NU-Horizonsat/ADCS-Camera-Payload-Board/RT1050.step

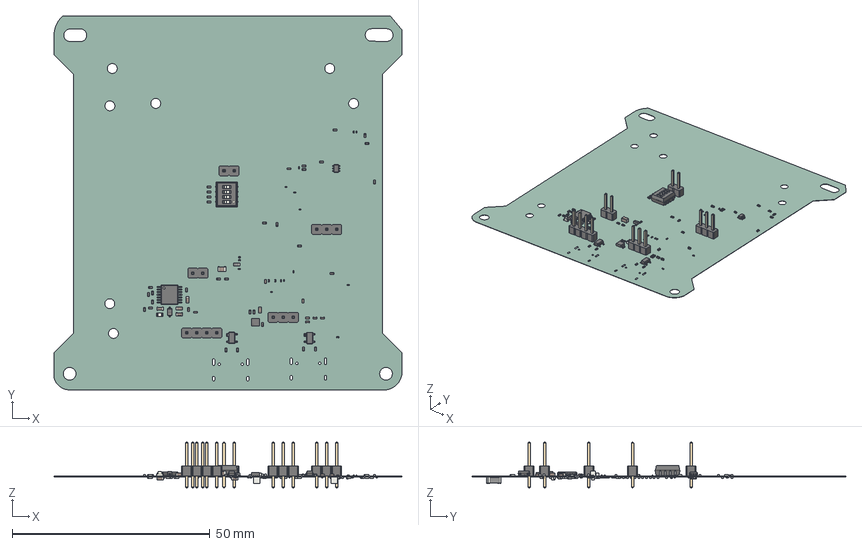
[picture p1: CAD file, 2025-04-02]
RT1050.step
88.0 x 94.5 x 11.5 mm
C_0201_0603Metric x 61
R_0402_1005Metric x 67
D_SOD-323
C_0603_1608Metric x 7
C_0402_1005Metric x 17
PinHeader_1x03_P2.54mm_Vertical x 2
SOT-143 x 2
SOT-363_SC-70-6
C_0805_2012Metric
LED_0603_1608Metric
TSSOP-14_4.4x5mm_P0.65mm
SW_DIP_SPSTx04_Slide_Copal_CHS-04A_W5.08mm_P1.27mm_JPin
PinHeader_1x02_P2.54mm_Vertical x 2
PinHeader_1x04_P2.54mm_Vertical
WSON-8-1EP_2x2mm_P0.5mm_EP0.9x1.6mm
L_0603_1608Metric
L_0402_1005Metric x 2
L_1206_3216Metric x 2
RT1050_PCB
