NU-Horizonsat/ADCS-Camera-Payload-Board/RT1050.pdf

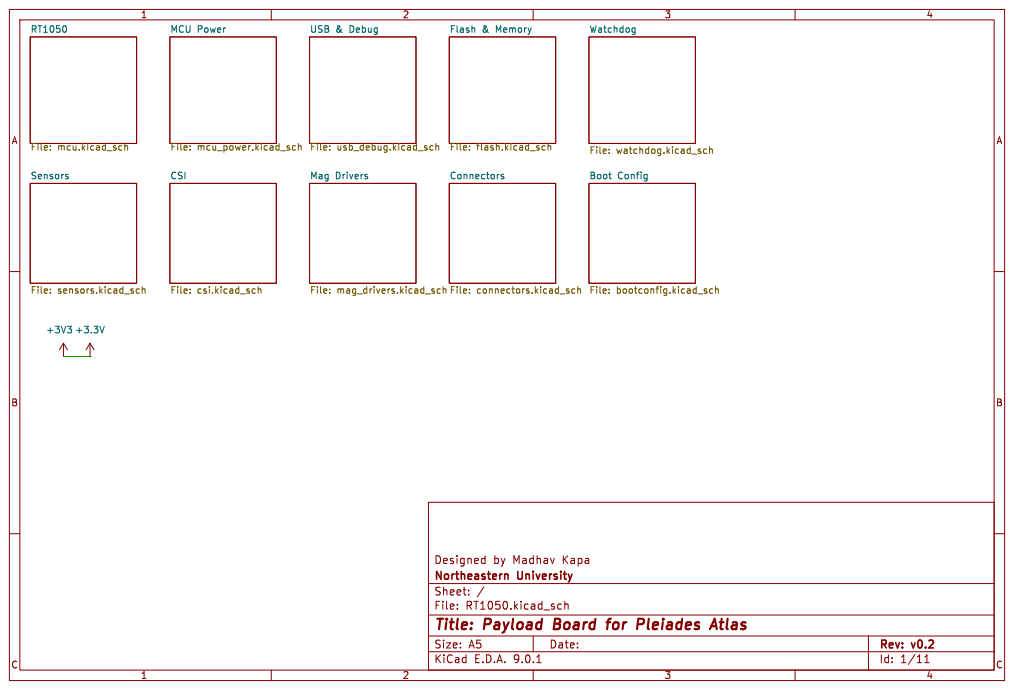
[picture p2: page 1]

Id: 1/11 Title: Payload Board for Pleiades Atlas

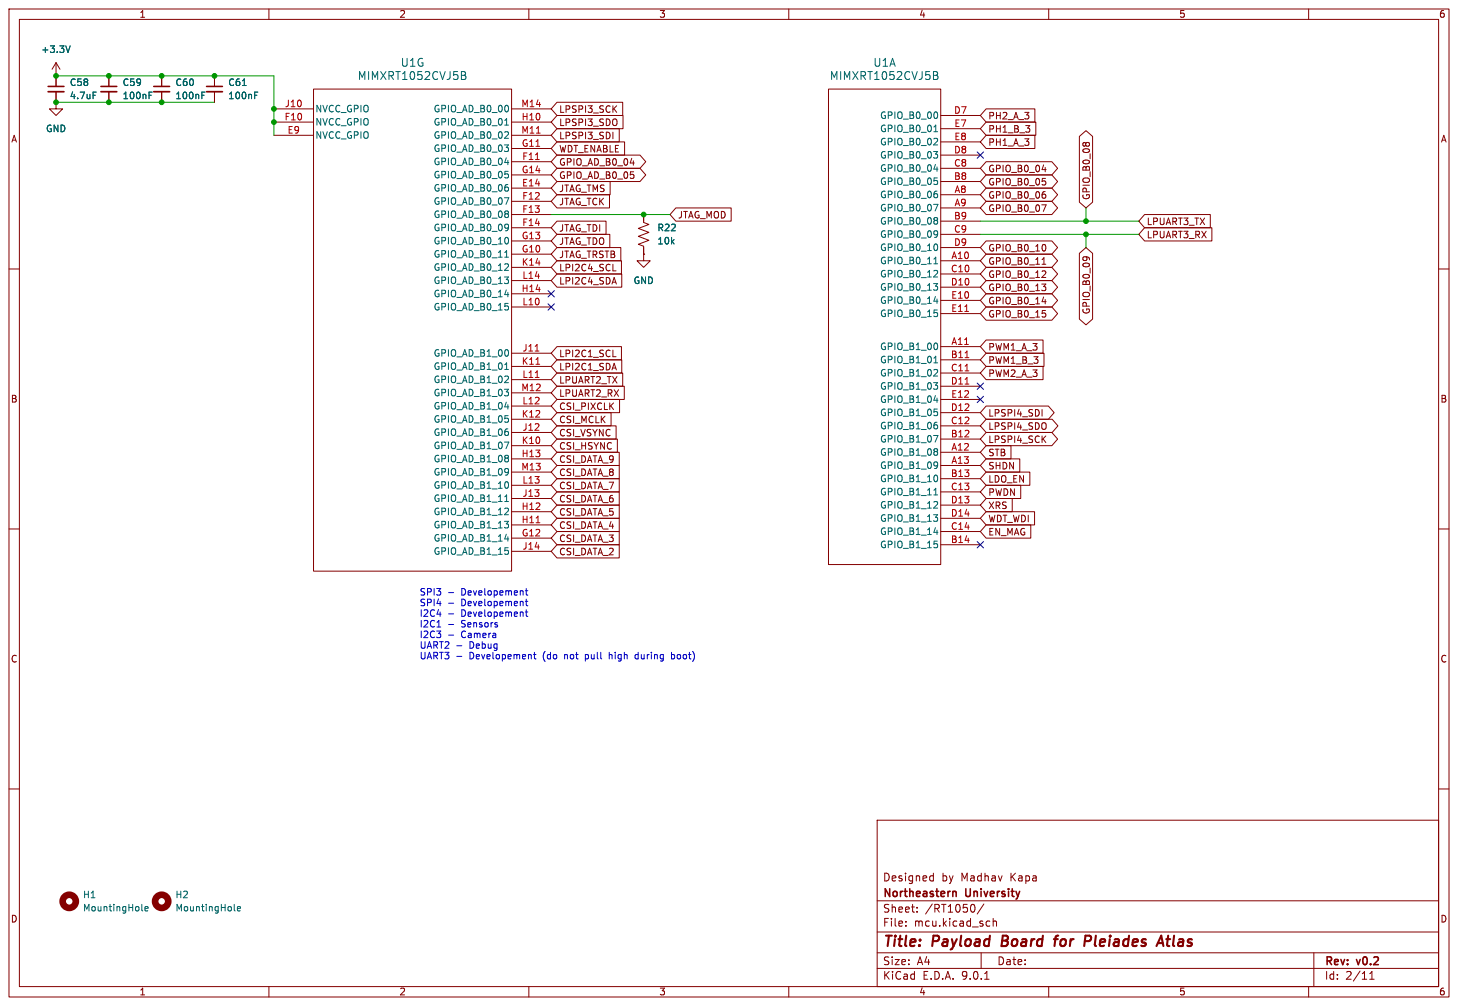
[picture p3: page 2]

Id: 2/11 Title: Payload Board for Pleiades Atlas

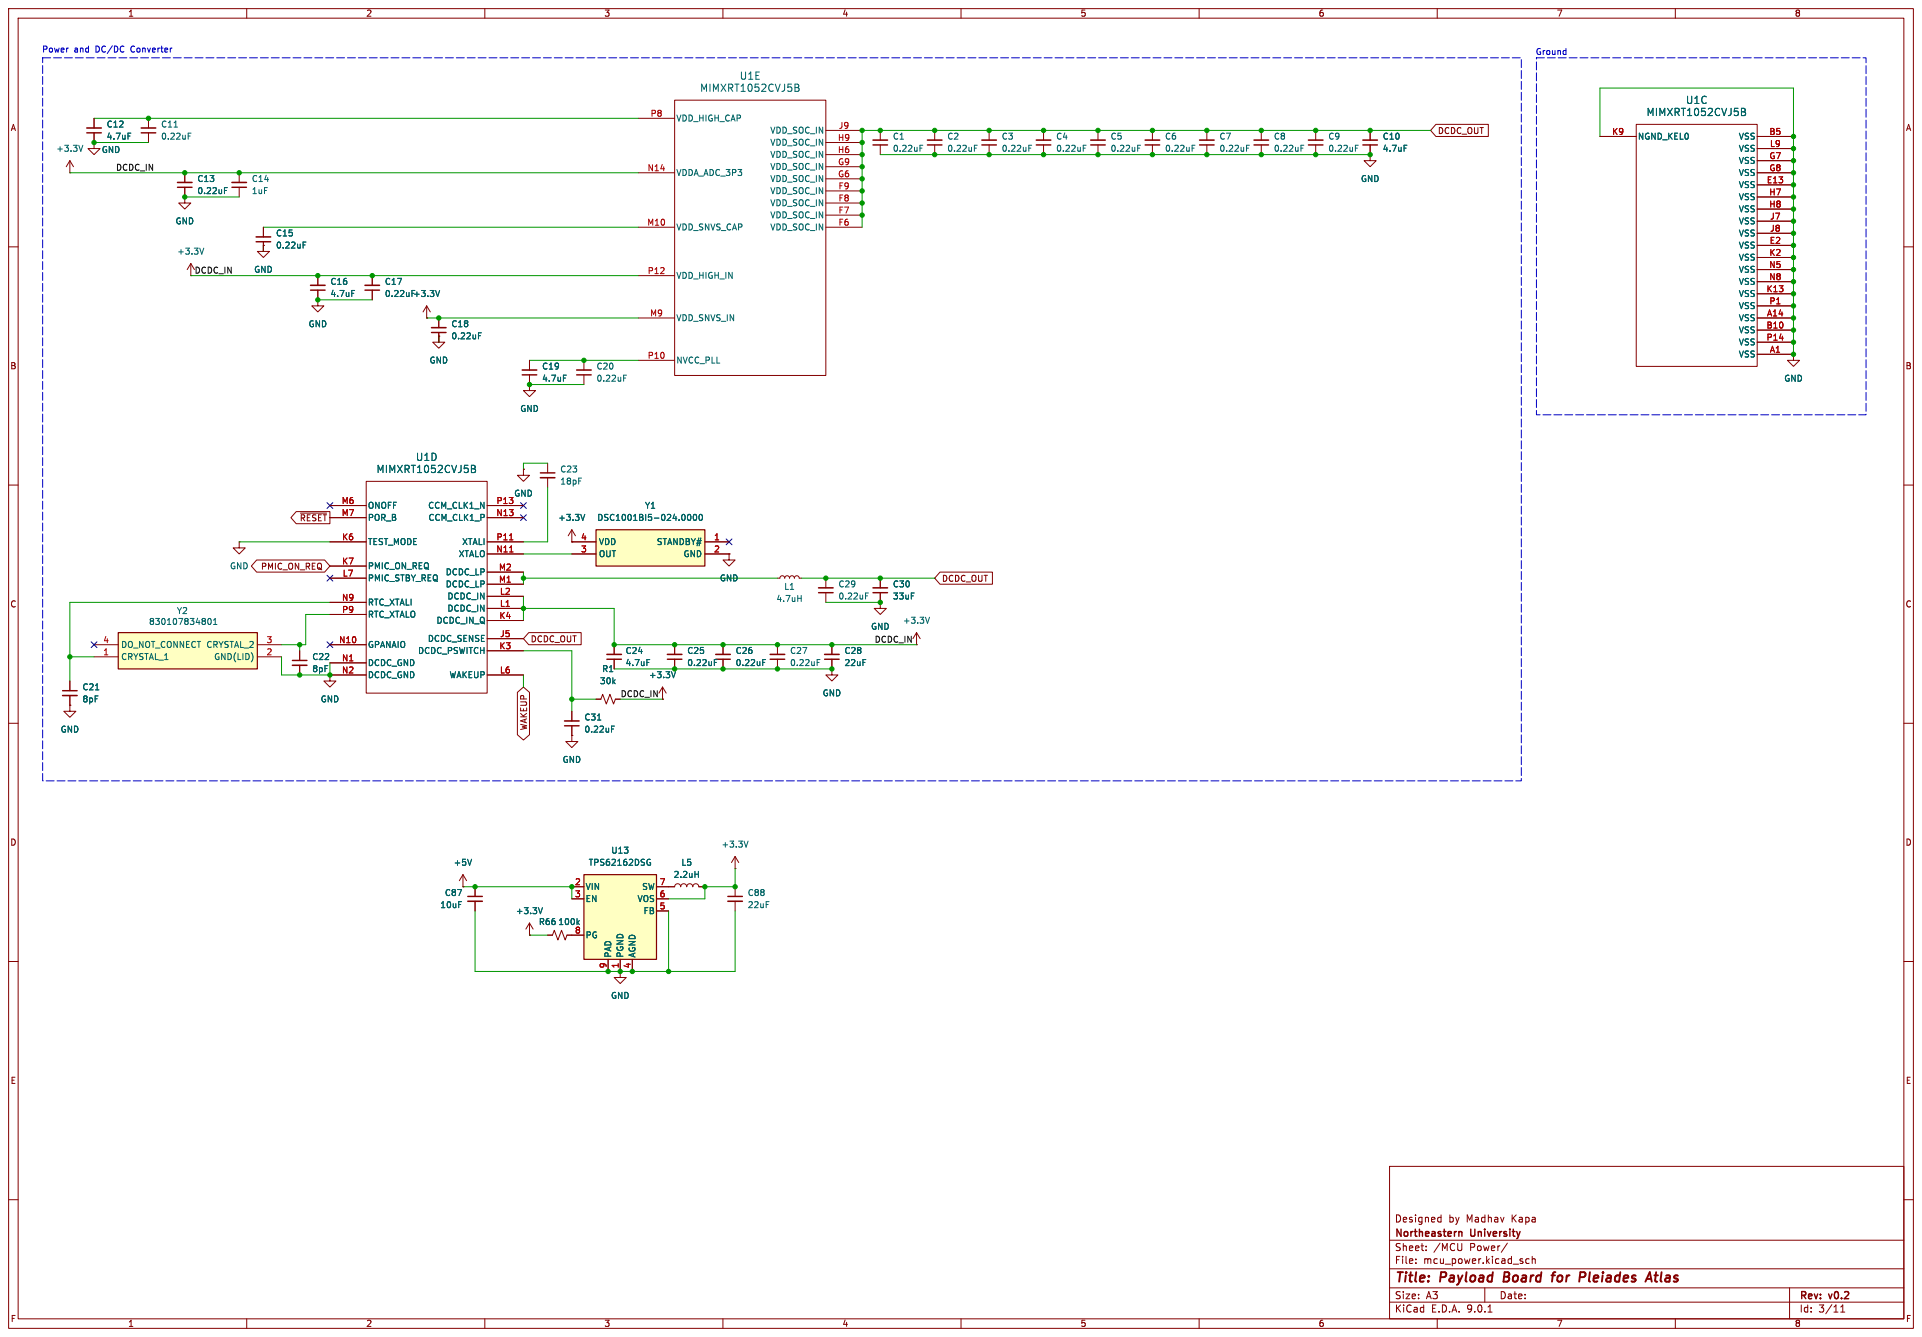
[picture p4: page 3]

Id: 3/11 Title: Payload Board for Pleiades Atlas

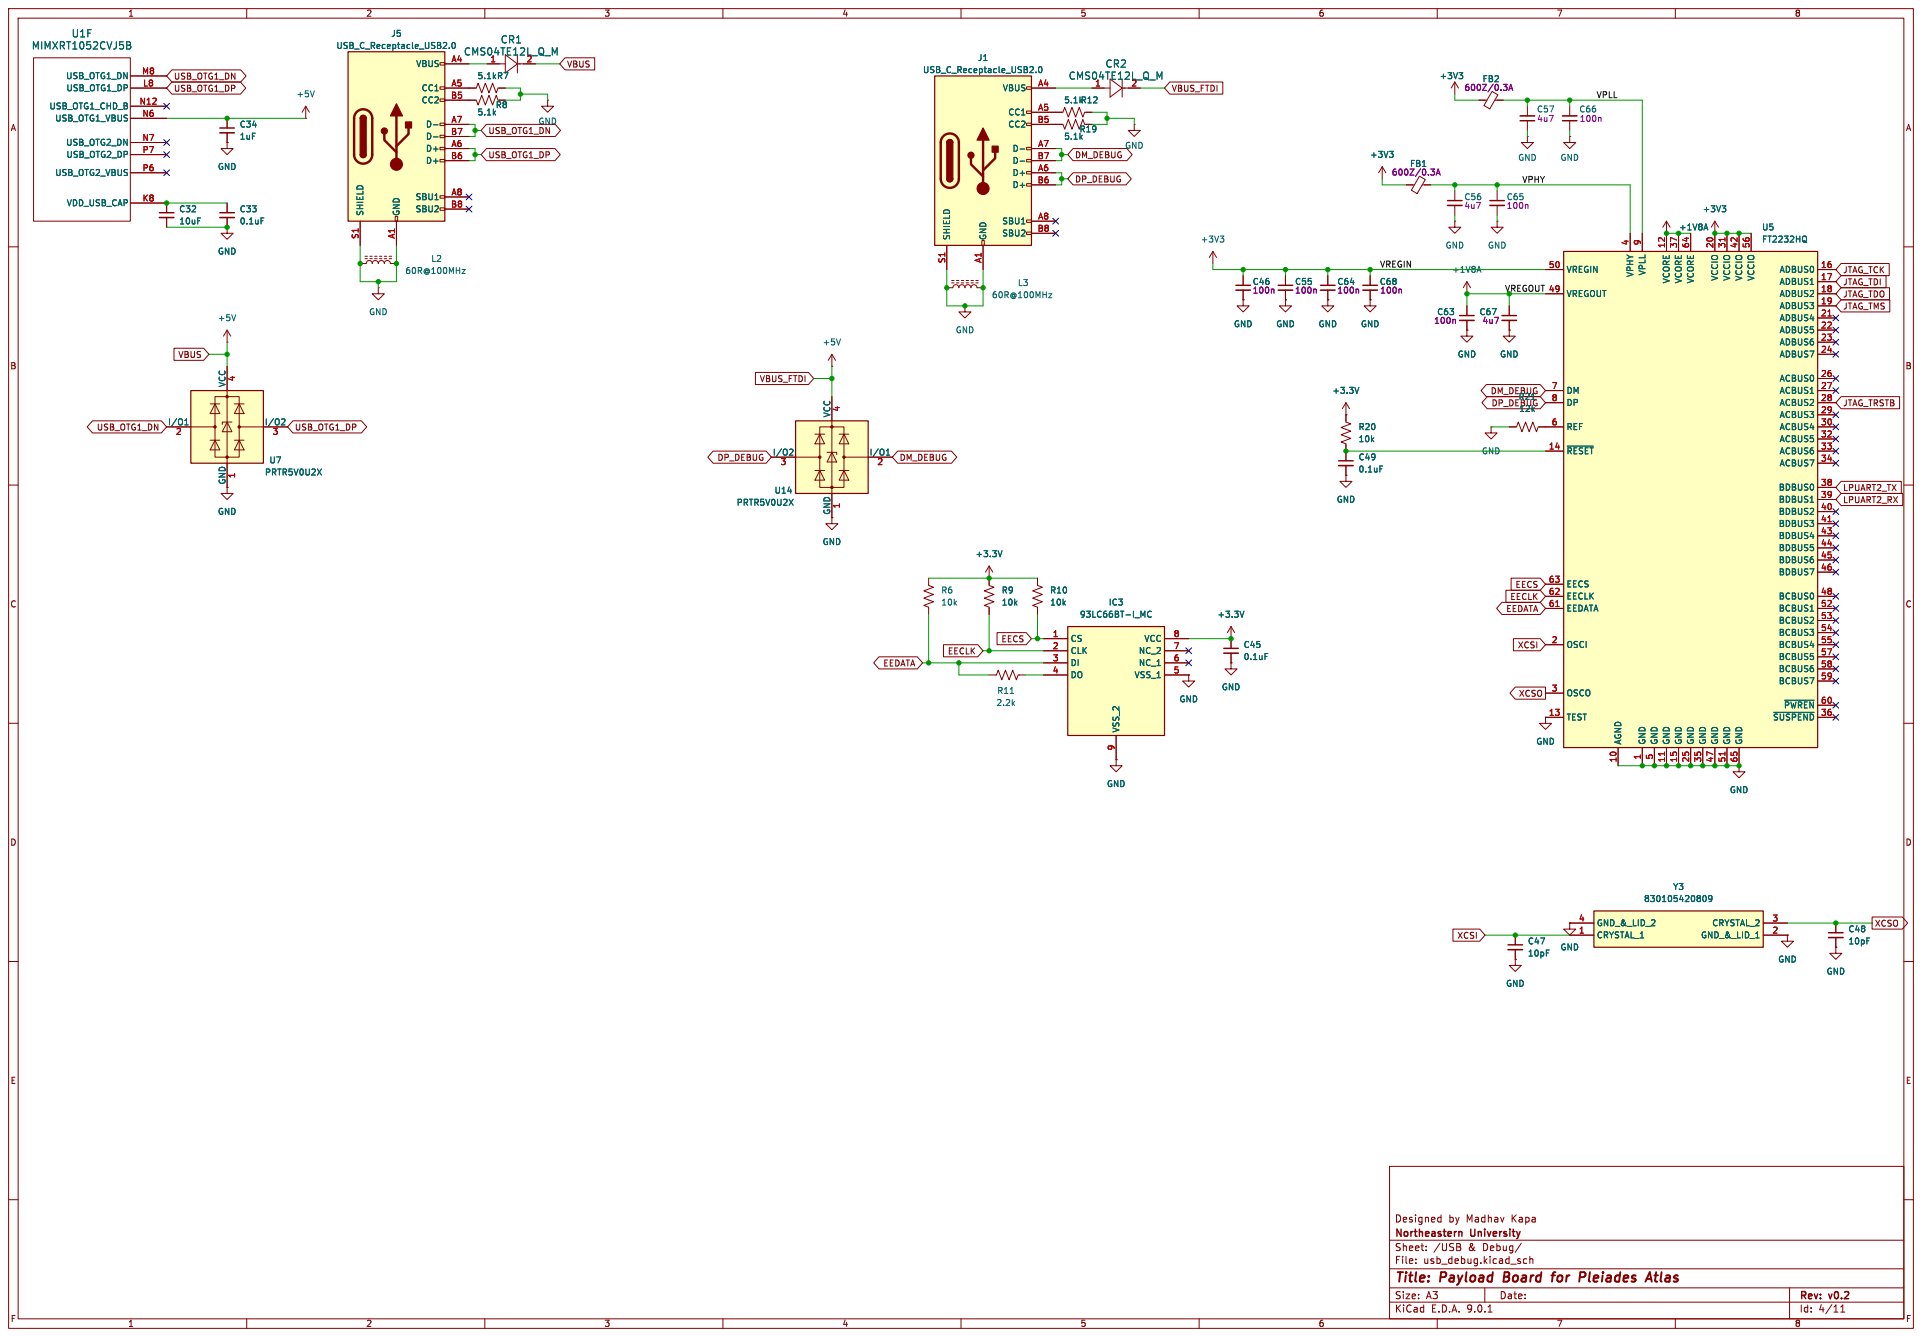
[picture p5: page 4]

5 VCORE 12 GND 11 VCORE 37 GND 15 VCORE 64 GND 25 GND 35 VCCIO 20 GND 47 VCCIO 31 GND 51 VCCIO 42 GND 65 VCCIO 56 ADBUS0

Id: 4/11 Title: Payload Board for Pleiades Atlas

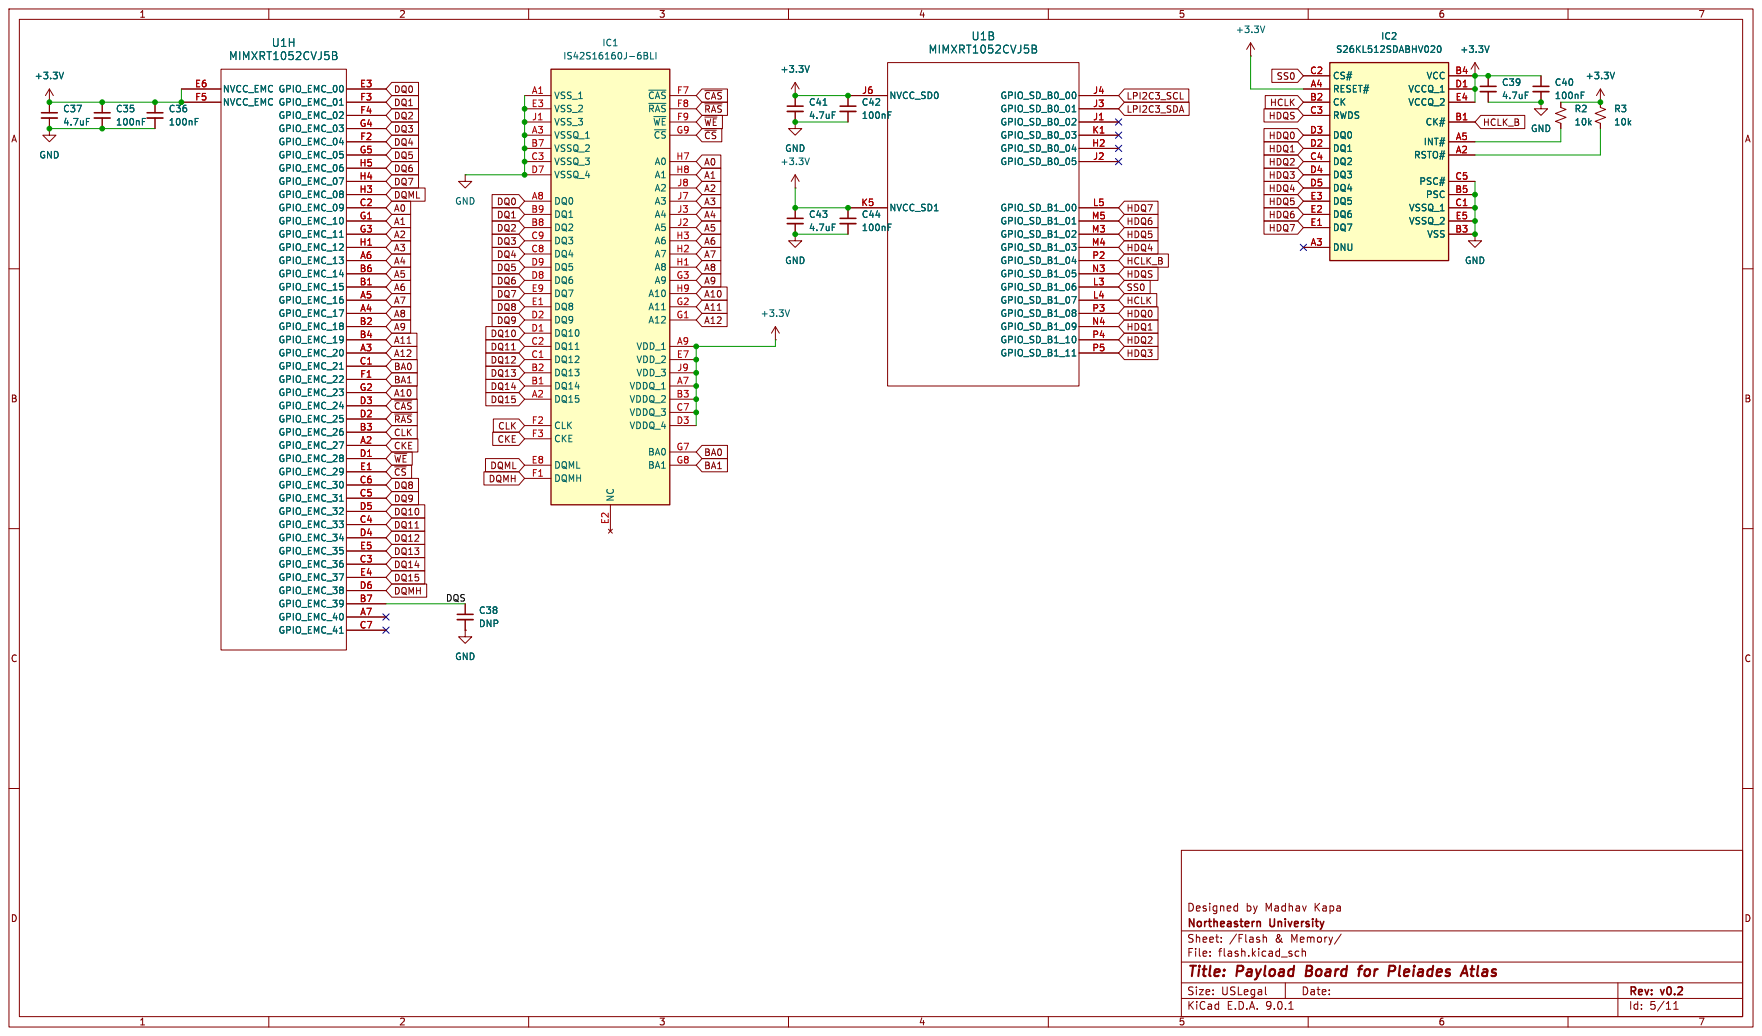
[picture p6: page 5]

~{CAS}F7 ~{RAS}F8 ~{WE}F9 ~{CS}G9 A0 H7 A1 H8 A2 J8 A3 J7 A4 J3 A5 J2 A6 H3 A7 H2 A8 H1 A9 G3 A10 H9 A11 G2 A12 G1 VDD_1 A9 VDD_2 E7 VDD_3 J9 VDDQ_1 A7 VDDQ_2 B3 VDDQ_3 C7 VDDQ_4 D3 BA0 G7 BA1 G8

Id: 5/11 Title: Payload Board for Pleiades Atlas

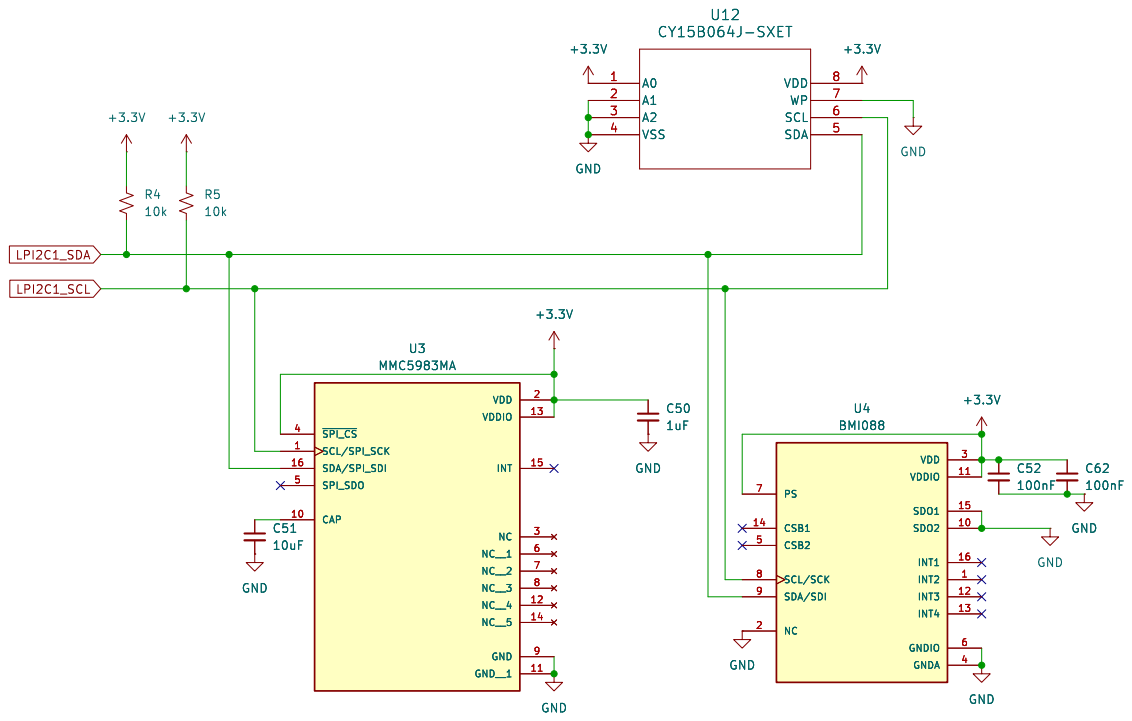
[picture p7: page 6]

Id: 6/11 Title: Payload Board for Pleiades Atlas

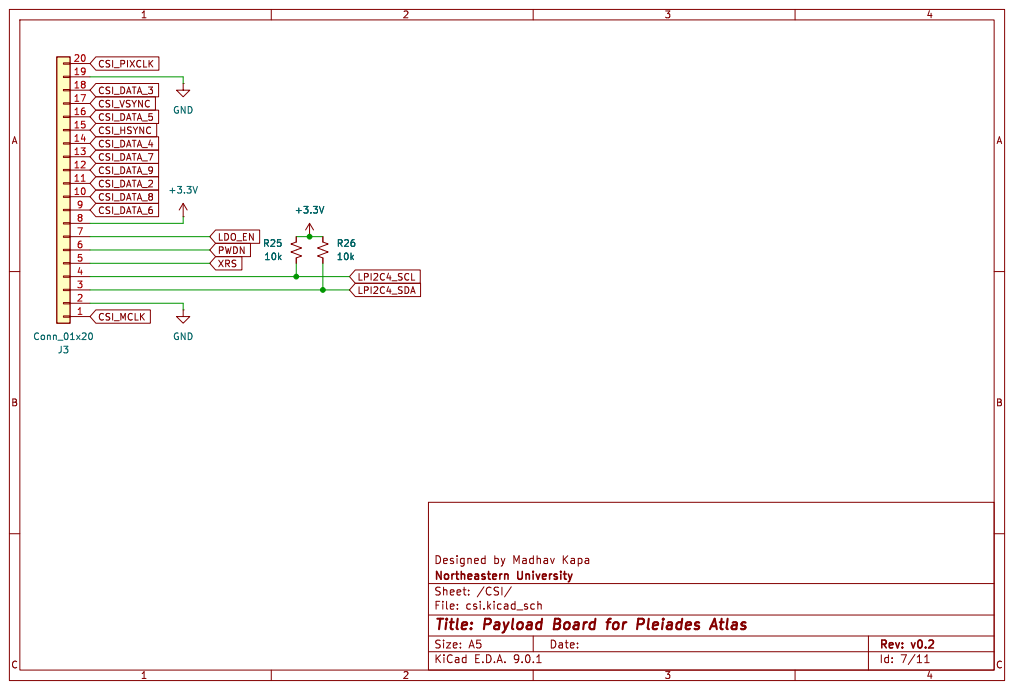
[picture p8: page 7]

Id: 7/11 Title: Payload Board for Pleiades Atlas

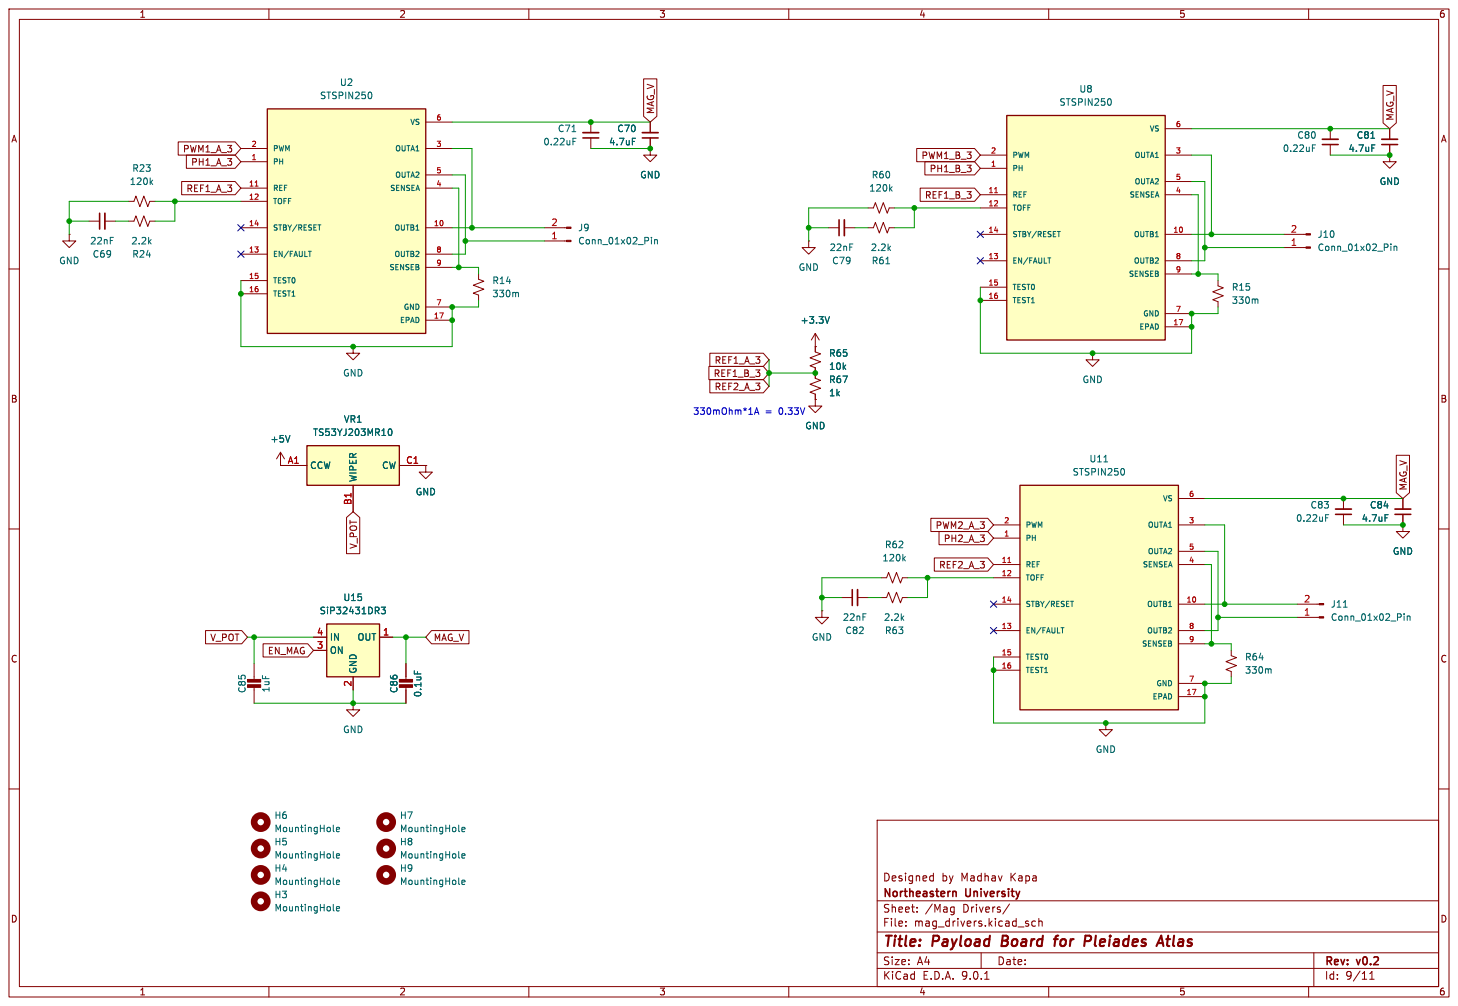
[picture p9: page 8]

Id: 9/11 Title: Payload Board for Pleiades Atlas

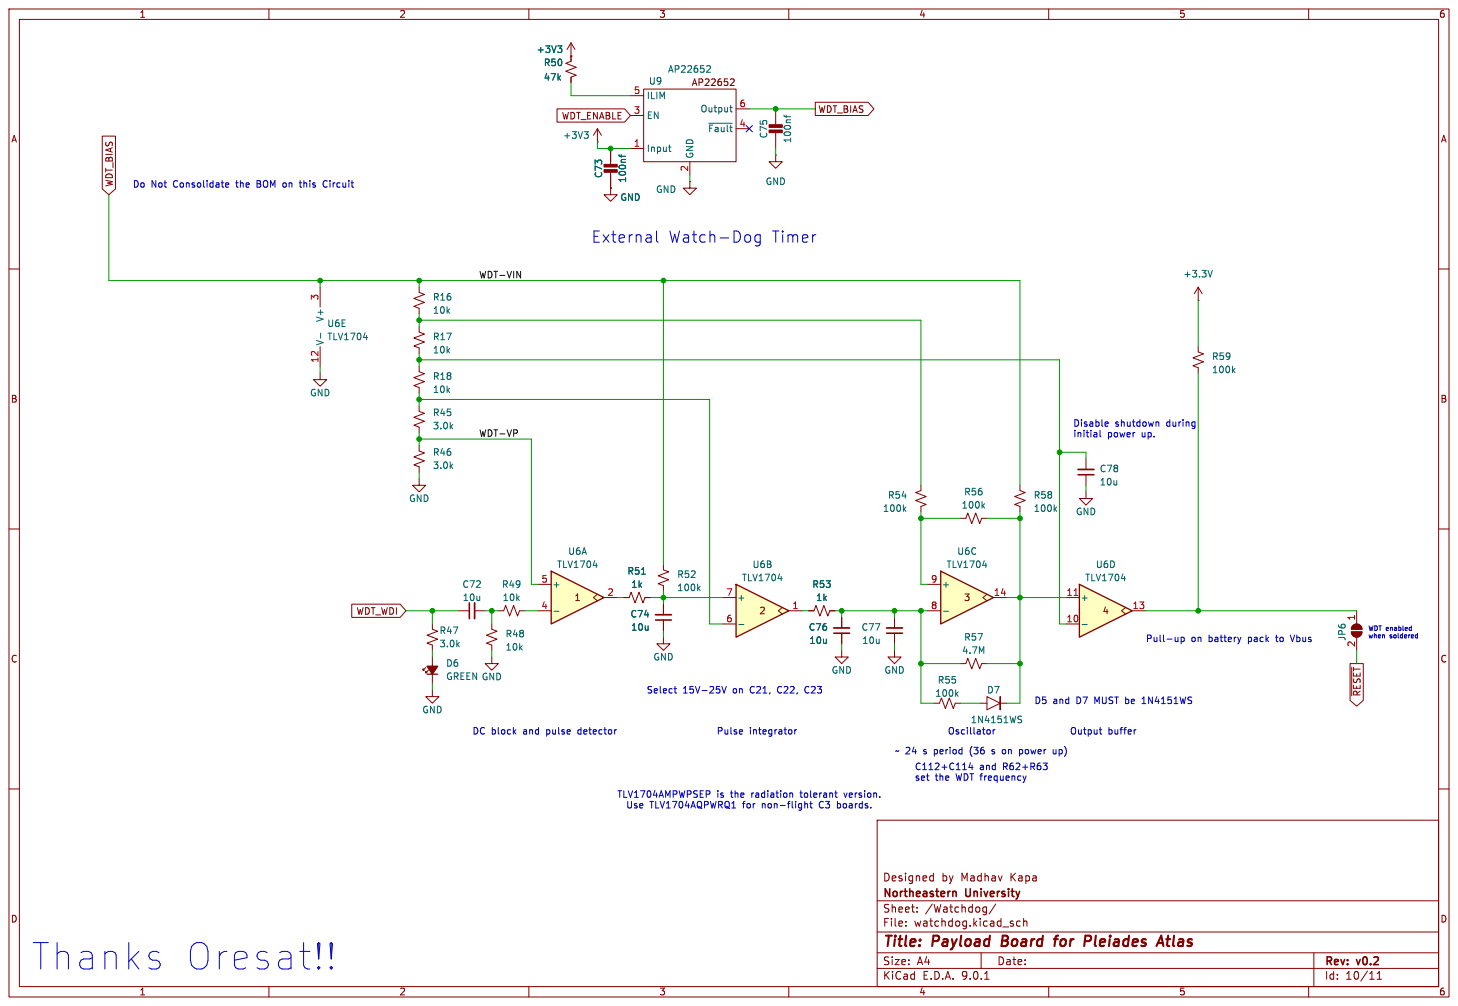
[picture p10: page 9]

2 Output 6 ~{Fault}4 U9 AP22652 ~{RESET} WDT_BIAS WDT_WDI WDT_BIAS WDT_ENABLE WDT-VP WDT-VIN

Id: 10/11 Title: Payload Board for Pleiades Atlas

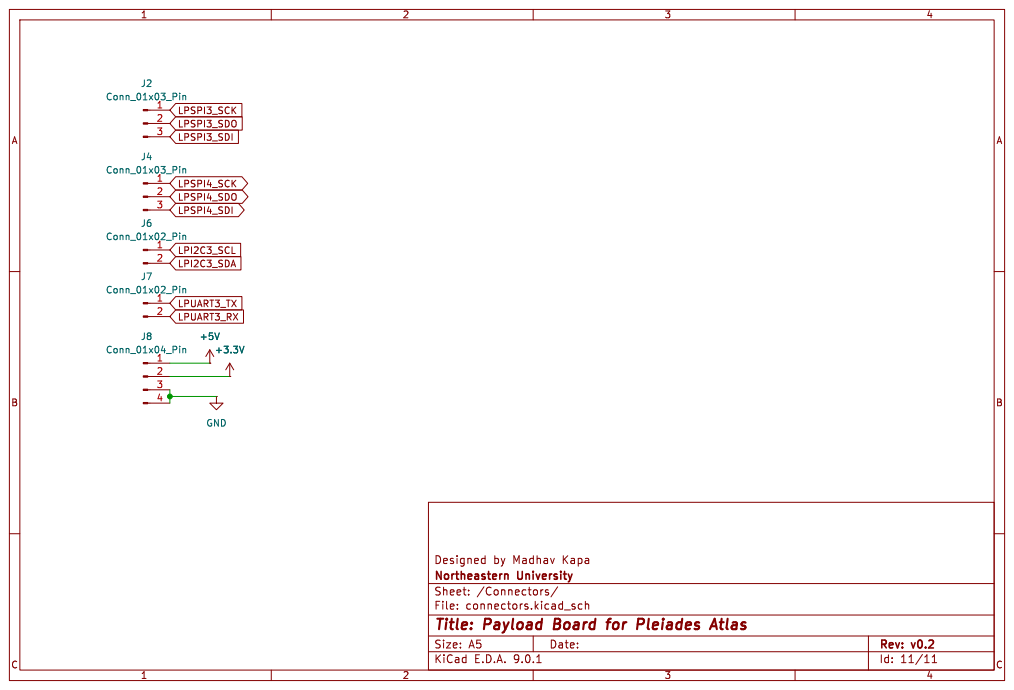
[picture p11: page 10]

Id: 11/11 Title: Payload Board for Pleiades Atlas

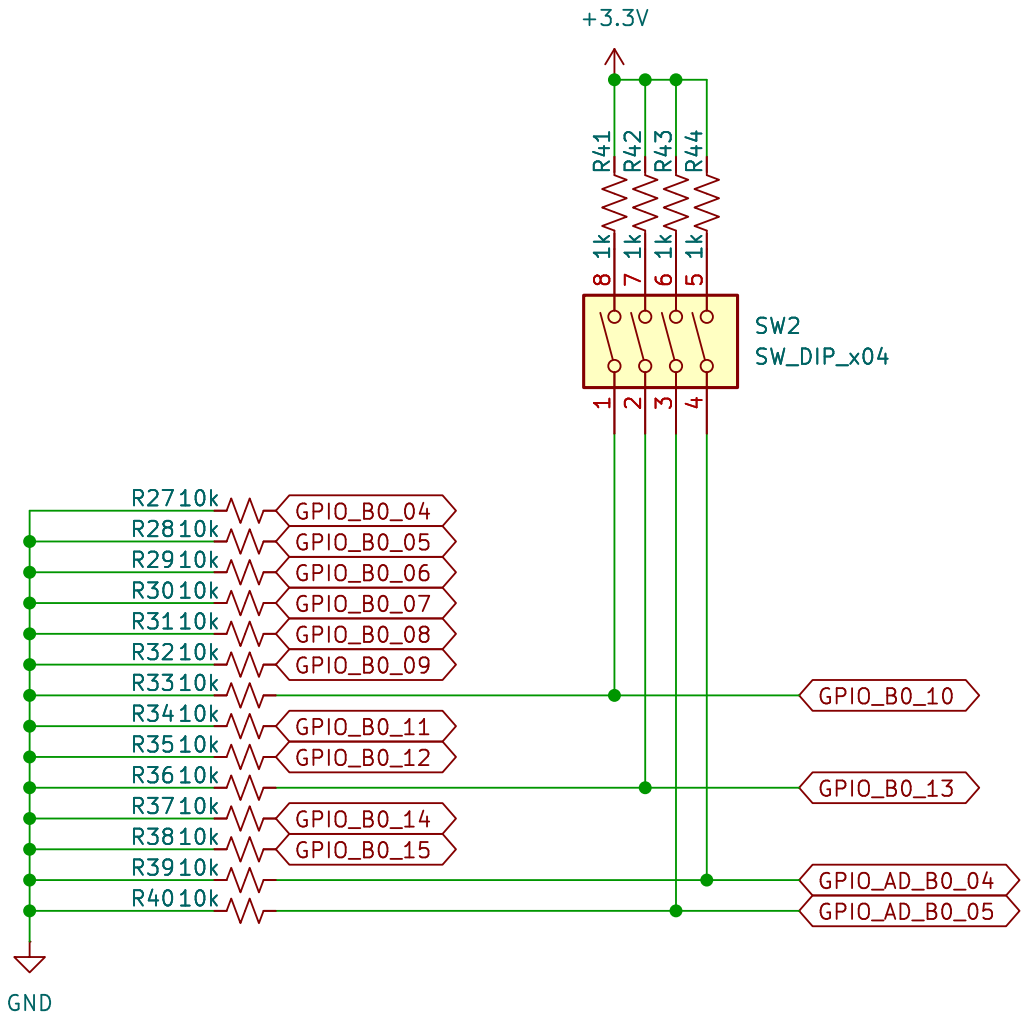
[picture p12: page 11]

Id: 11/11 Title: Payload Board for Pleiades Atlas
