NU-Horizonsat/ADCS-Camera-Payload-Board/RT1050.kicad_pcb

## KiCad design RT1050.kicad_pcb (2025-04-02)

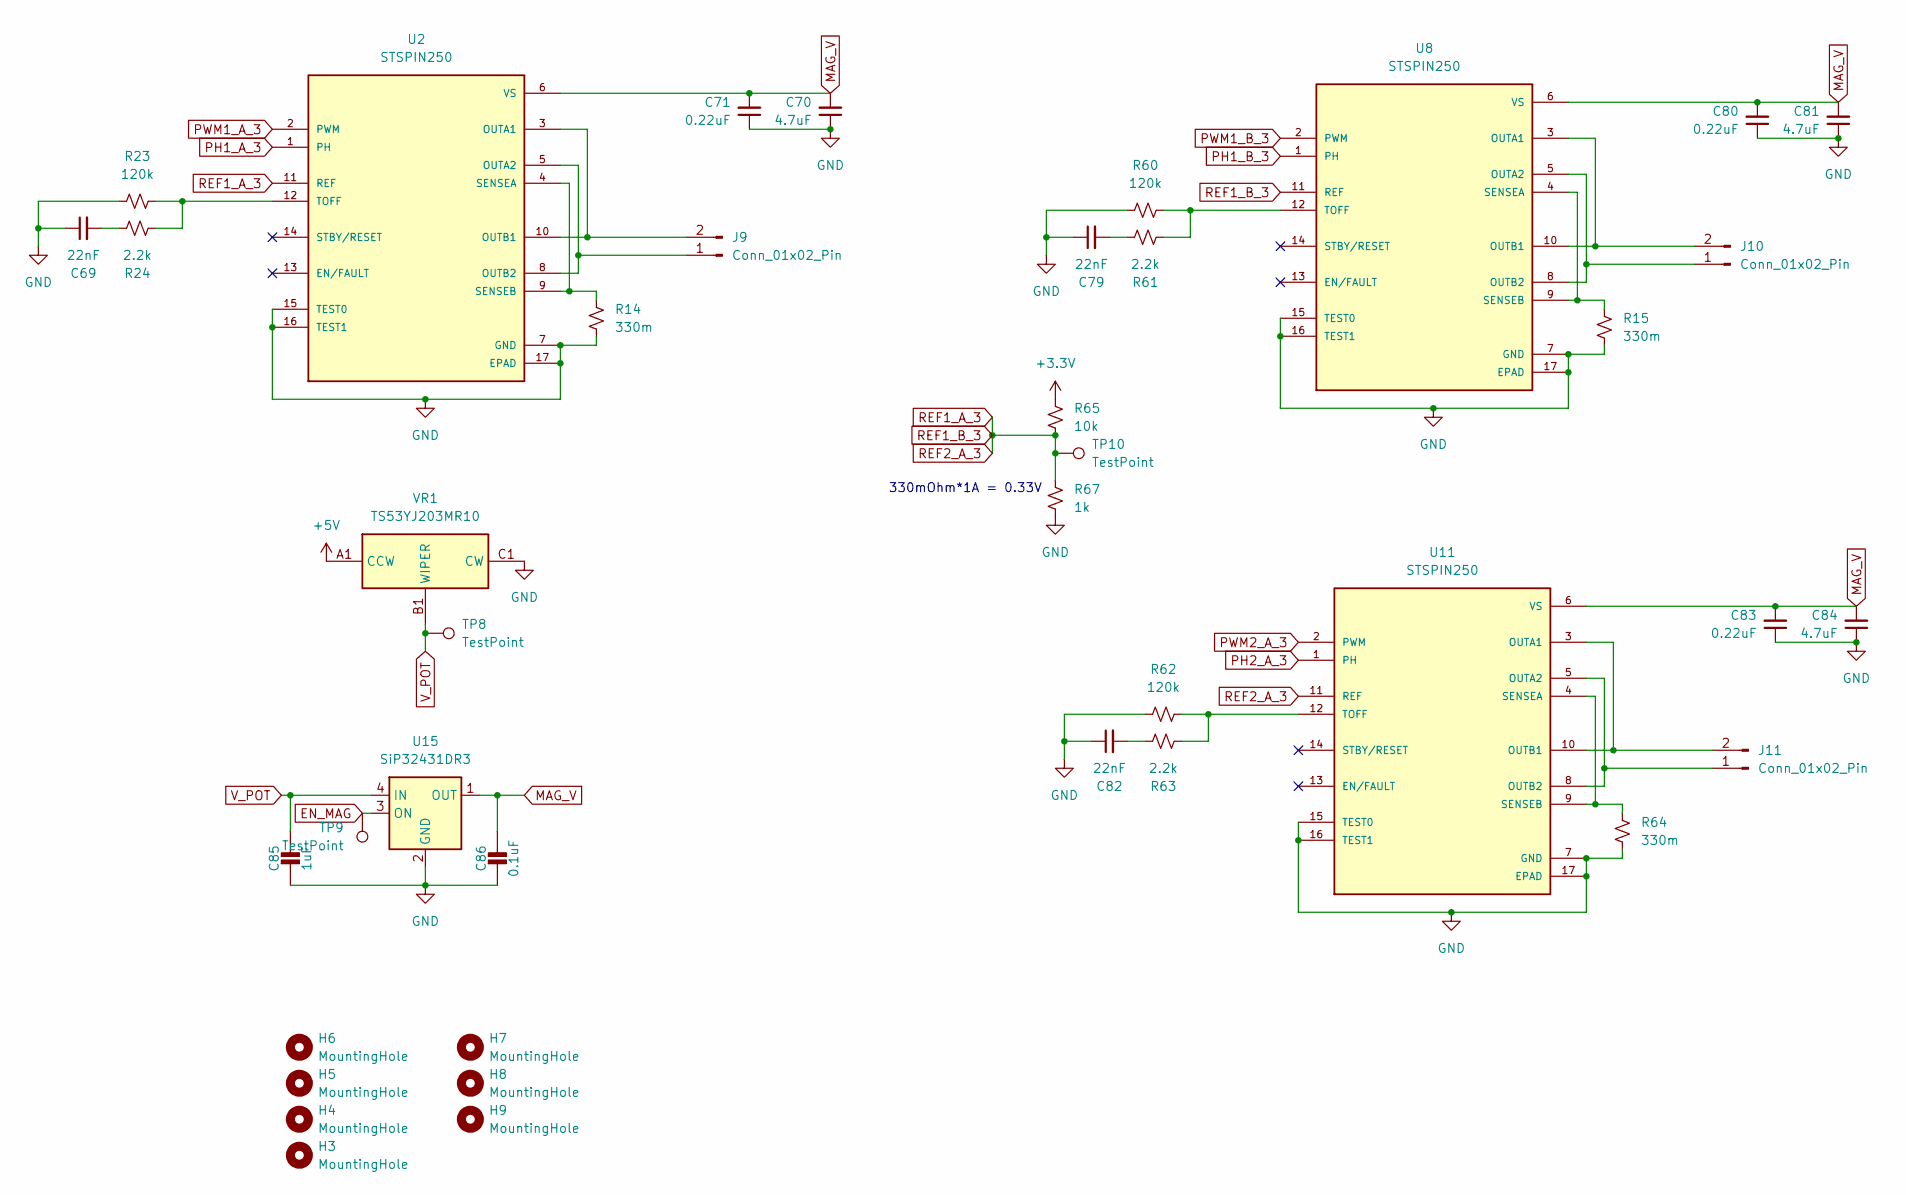
[picture p13: schematic mag_drivers.kicad_sch, Payload Board for Pleiades Atlas]

Parts:
C69, C79, C82: 22nF; C_0201_0603Metric
C70, C81, C84: 4.7uF; C_0201_0603Metric
C71, C80, C83: 0.22uF; C_0201_0603Metric
C85: 1uF; C_0402_1005Metric
C86: 0.1uF; C_0402_1005Metric
H3, H4, H5, H6, H7, H8, H9: MountingHole; MountingHole_2.5mm_Pad
J9, J10, J11: Conn_01x02_Pin; JST_SH_BM02B-SRSS-TB_1x02-1MP_P1.00mm_Vertical
R14, R15, R64: 330m; R_0402_1005Metric
R23, R60, R62: 120k; R_0402_1005Metric
R24, R61, R63: 2.2k; R_0402_1005Metric
R65: 10k; R_0402_1005Metric
R67: 1k; R_0402_1005Metric
TP8, TP9, TP10: TestPoint; TestPoint_Pad_D1.5mm
U2, U8, U11: STSPIN250; QFN50P300X300X100-17N; PARTREV 2
U15: SiP32431DR3; SOT-363_SC-70-6
VR1: TS53YJ203MR10; Mouser Part Number 72-TS53YJ-20K

Connections:
EN_MAG: TP9.1, U15.3 (ON); also elsewhere on the board
GND: C69.1, C70.1, C71.1, C79.1, C80.1, C81.1, C82.1, C83.1, C84.1, C85.2, C86.2, R14.2, R15.2, R23.1, R60.1, R62.1, R64.2, R67.1, U2.7 (GND), U2.15 (TEST0), U2.16 (TEST1), U2.17 (EPAD), U8.7 (GND), U8.15 (TEST0), U8.16 (TEST1), U8.17 (EPAD), U11.7 (GND), U11.15 (TEST0), U11.16 (TEST1), U11.17 (EPAD), U15.2 (GND), U15.5 (GND), VR1.C1 (CW); also elsewhere on the board
MAG_V: C70.2, C71.2, C80.2, C81.2, C83.2, C84.2, C86.1, U2.6 (VS), U8.6 (VS), U11.6 (VS), U15.1 (OUT)
unnamed: C69.2, R24.2
unnamed: C79.2, R61.2
unnamed: C82.2, R63.2
unnamed: J9.1, U2.5 (OUTA2), U2.8 (OUTB2)
unnamed: J9.2, U2.3 (OUTA1), U2.10 (OUTB1)
unnamed: J10.1, U8.5 (OUTA2), U8.8 (OUTB2)
unnamed: J10.2, U8.3 (OUTA1), U8.10 (OUTB1)
unnamed: J11.1, U11.5 (OUTA2), U11.8 (OUTB2)
unnamed: J11.2, U11.3 (OUTA1), U11.10 (OUTB1)
unnamed: R14.1, U2.4 (SENSEA), U2.9 (SENSEB)
unnamed: R23.2, R24.1, U2.12 (TOFF)
unnamed: R15.1, U8.4 (SENSEA), U8.9 (SENSEB)
unnamed: R60.2, R61.1, U8.12 (TOFF)
unnamed: R64.1, U11.4 (SENSEA), U11.9 (SENSEB)
unnamed: R62.2, R63.1, U11.12 (TOFF)
PH1_A_3: U2.1 (PH); also elsewhere on the board
PH1_B_3: U8.1 (PH); also elsewhere on the board
PH2_A_3: U11.1 (PH); also elsewhere on the board
PWM1_A_3: U2.2 (PWM); also elsewhere on the board
PWM1_B_3: U8.2 (PWM); also elsewhere on the board
PWM2_A_3: U11.2 (PWM); also elsewhere on the board
REF1_A_3: R65.1, R67.2, TP10.1, U2.11 (REF), U8.11 (REF), U11.11 (REF)
VBUS: VR1.A1 (CCW); also elsewhere on the board
V_POT: C85.1, TP8.1, U15.4 (IN), VR1.B1 (WIPER)

Notes on the sheet:
330mOhm*1A = 0.33V

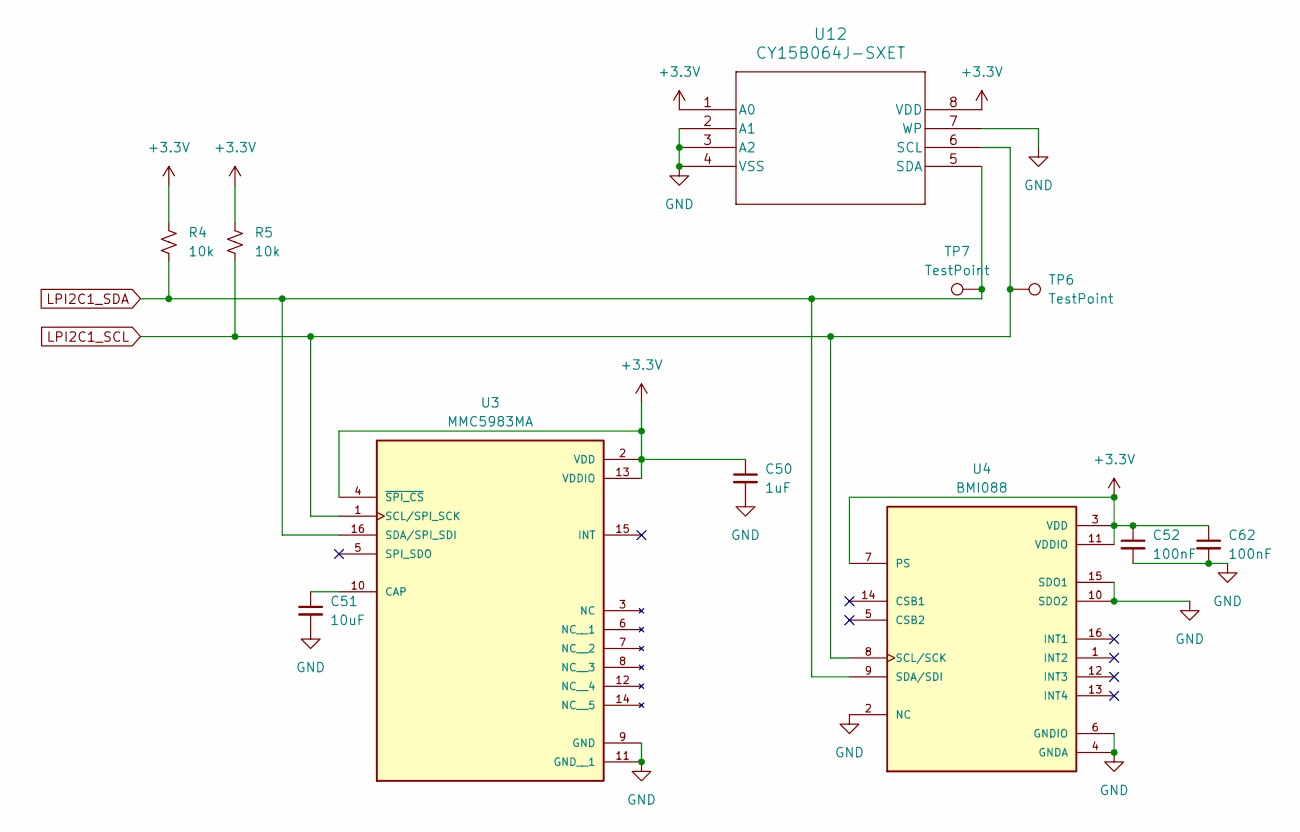
[picture p14: schematic sensors.kicad_sch, Payload Board for Pleiades Atlas]

Parts:
C50: 1uF; C_0201_0603Metric
C51: 10uF; C_0402_1005Metric
C52, C62: 100nF; C_0201_0603Metric
R4, R5: 10k; R_0402_1005Metric
TP6, TP7: TestPoint; TestPoint_Pad_D1.5mm
U3: MMC5983MA; MMC5983MA_MEM; PARTREV A
U4: BMI088; QFN_BMI085_BOS
U12: CY15B064J-SXET; SO8_CY15_CYP

Connections:
GND: C50.2, C51.2, C52.2, C62.2, U3.9 (GND), U3.11 (GND__1), U4.2 (NC), U4.4 (GNDA), U4.6 (GNDIO), U4.10 (SDO2), U4.15 (SDO1), U12.2 (A1), U12.3 (A2), U12.4 (VSS), U12.7 (WP); also elsewhere on the board
LPI2C1_SCL: R5.2, TP6.1, U3.1 (SCL/SPI_SCK), U4.8 (SCL/SCK), U12.6 (SCL); also elsewhere on the board
LPI2C1_SDA: R4.2, TP7.1, U3.16 (SDA/SPI_SDI), U4.9 (SDA/SDI), U12.5 (SDA); also elsewhere on the board
unnamed: C51.1, U3.10 (CAP)

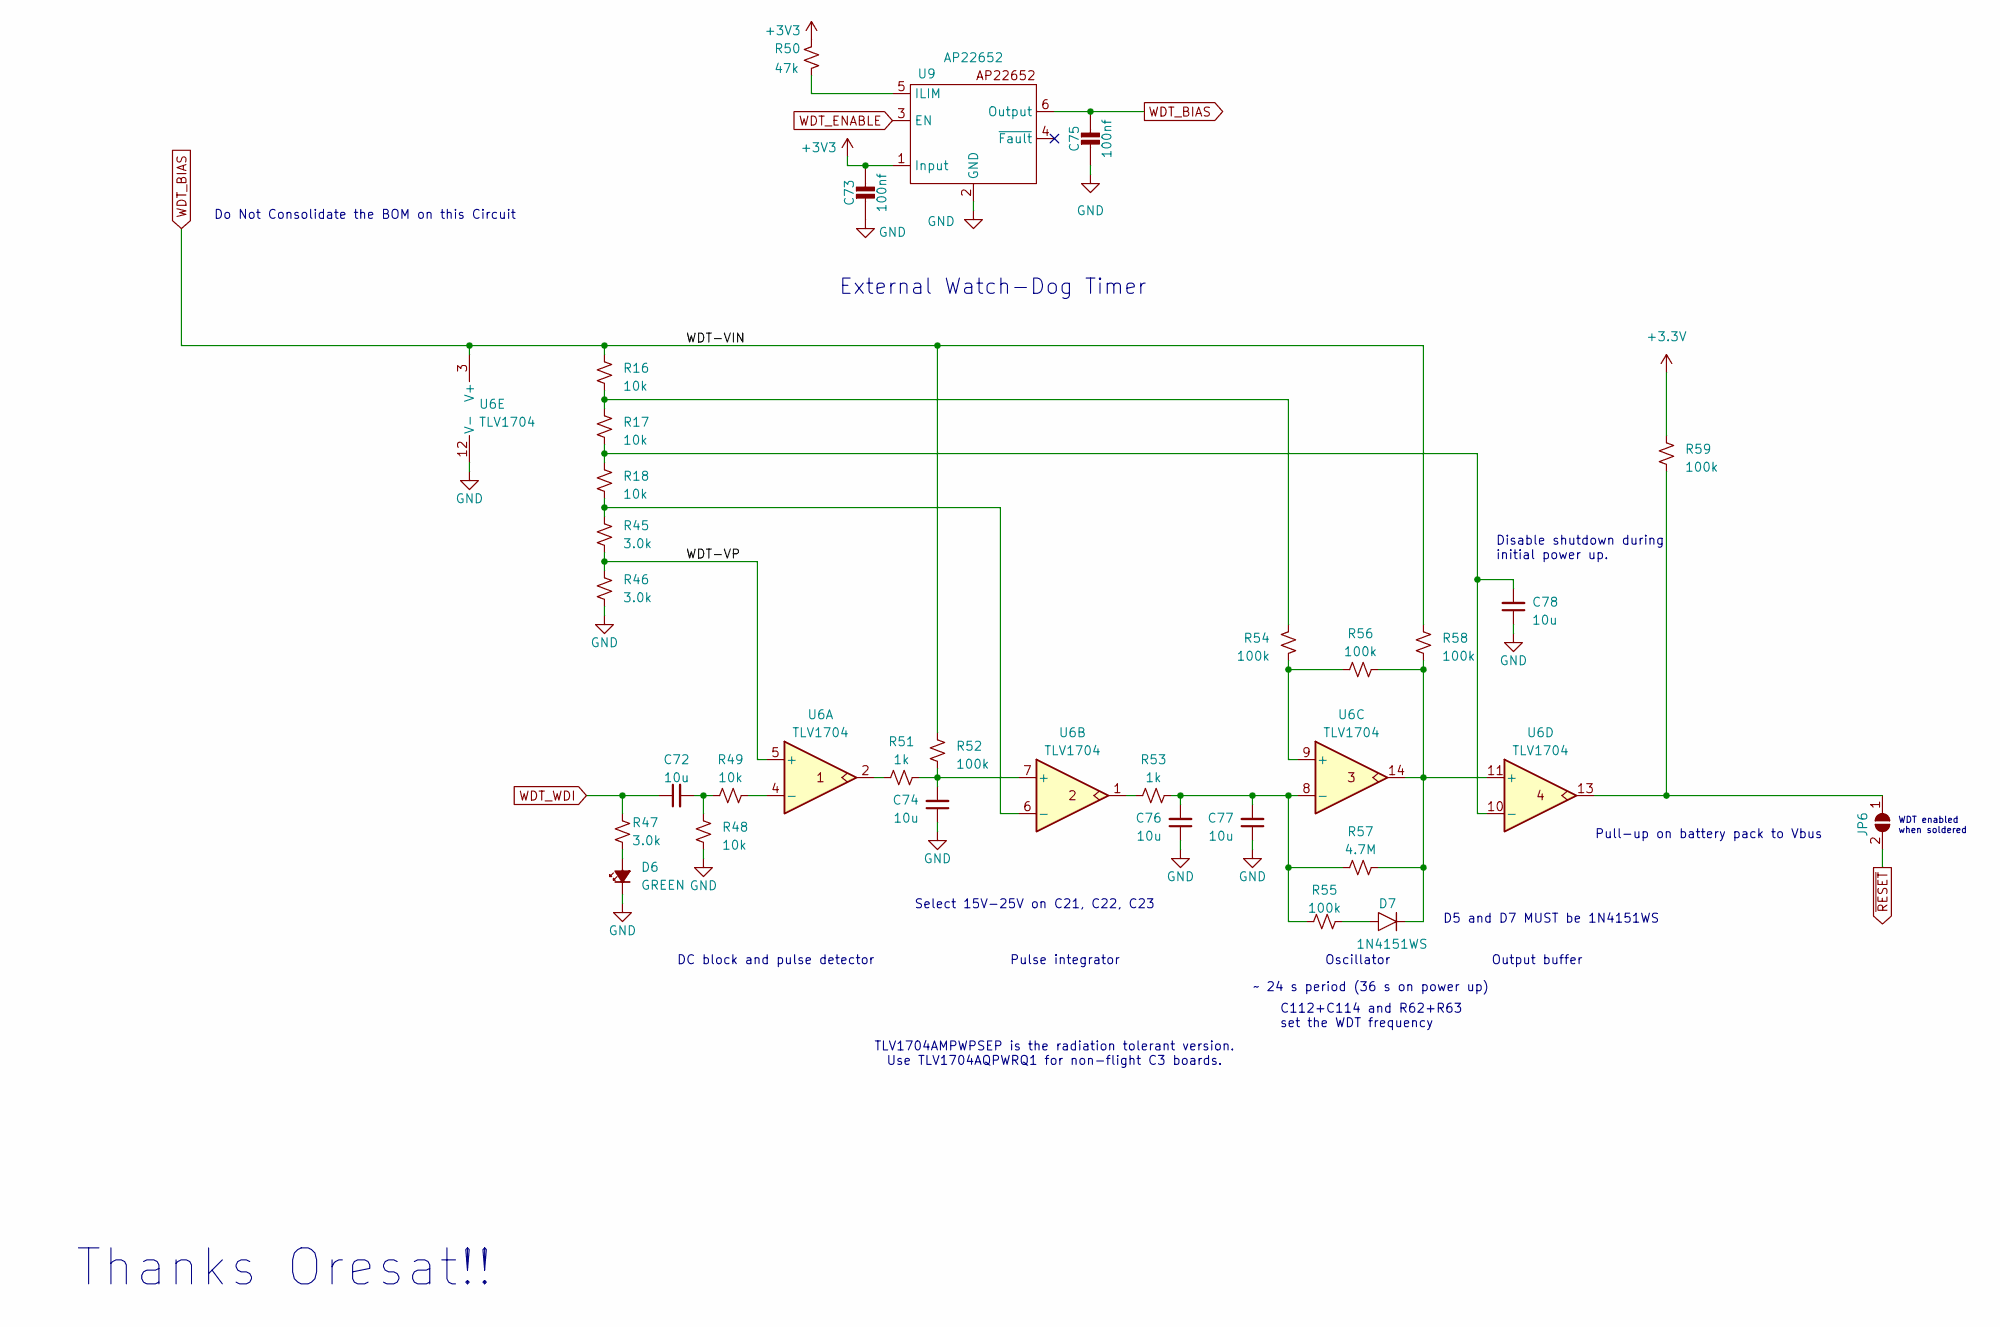
[picture p15: schematic watchdog.kicad_sch, Payload Board for Pleiades Atlas]

Parts:
C72, C74, C76, C77, C78: 10u; C_0603_1608Metric; MPN GRT188R61C106KE13D
C73, C75: 100nf; C_0402_1005Metric
D6: GREEN; LED_0603_1608Metric; MPN 150060GS75000
D7: 1N4151WS; D_SOD-323; MPN 1N4151WS-E3-08
JP6: SolderJumper_2_Open; SolderJumper-2_P1.3mm_Open_RoundedPad1.0x1.5mm
R16, R17, R18, R48, R49: 10k; R_0402_1005Metric; MPN RMCF0603FT10K0
R45, R46, R47: 3.0k; R_0402_1005Metric; MPN RMCF0603FT3K00
R50: 47k; R_0402_1005Metric; MPN RMCF0603FT47K0
R51, R53: 1k; R_0402_1005Metric; MPN RMCF0603FT1K00
R52, R54, R55, R56, R58, R59: 100k; R_0402_1005Metric; MPN RMCF0603FT100K
R57: 4.7M; R_0402_1005Metric; MPN RMCF0603FT4M70
U6: TLV1704; TSSOP-14_4.4x5mm_P0.65mm; MPN TLV1704AQPWRQ1
U9: AP22652; SOT95P280X145-6N

Connections:
/Watchdog/WDT-VP: R45.2, R46.1, U6.5 (+)
GND: C73.2, C74.1, C75.2, C76.1, C77.1, C78.1, D6.1 (K), R46.2, R48.2, U6.12 (V-), U9.2 (GND); also elsewhere on the board
unnamed: C72.2, R48.1, R49.1
unnamed: D6.2 (A), R47.2
unnamed: D7.2, R55.1
unnamed: JP6.1 (A), R59.1, U6.13
unnamed: R16.2, R17.1, R54.2
unnamed: R51.1, U6.2
unnamed: R53.1, U6.1
unnamed: R49.2, U6.4 (-)
unnamed: C74.2, R51.2, R52.2, U6.7 (+)
unnamed: R18.2, R45.1, U6.6 (-)
unnamed: R54.1, R56.1, U6.9 (+)
unnamed: C76.2, C77.2, R53.2, R55.2, R57.2, U6.8 (-)
unnamed: D7.1, R56.2, R57.1, R58.1, U6.11 (+), U6.14
unnamed: C78.2, R17.2, R18.1, U6.10 (-)
unnamed: R50.2, U9.5 (ILIM)
WDT_BIAS: C75.1, R16.1, R52.1, R58.2, U6.3 (V+), U9.6 (Output)
WDT_ENABLE: U9.3 (EN); also elsewhere on the board
WDT_WDI: C72.1, R47.1; also elsewhere on the board
~RESET: JP6.2 (B); also elsewhere on the board

Notes on the sheet:
Disable shutdown during initial power up.
WDT enabled when soldered
DC block and pulse detector
Thanks Oresat!!
Select 15V-25V on C21, C22, C23
Pulse integrator
~ 24 s period (36 s on power up)
C112+C114 and R62+R63 set the WDT frequency
Oscillator
TLV1704AMPWPSEP is the radiation tolerant version. Use TLV1704AQPWRQ1 for non-flight C3 boards.
Output buffer
Do Not Consolidate the BOM on this Circuit
Pull-up on battery pack to Vbus
External Watch-Dog Timer
D5 and D7 MUST be 1N4151WS

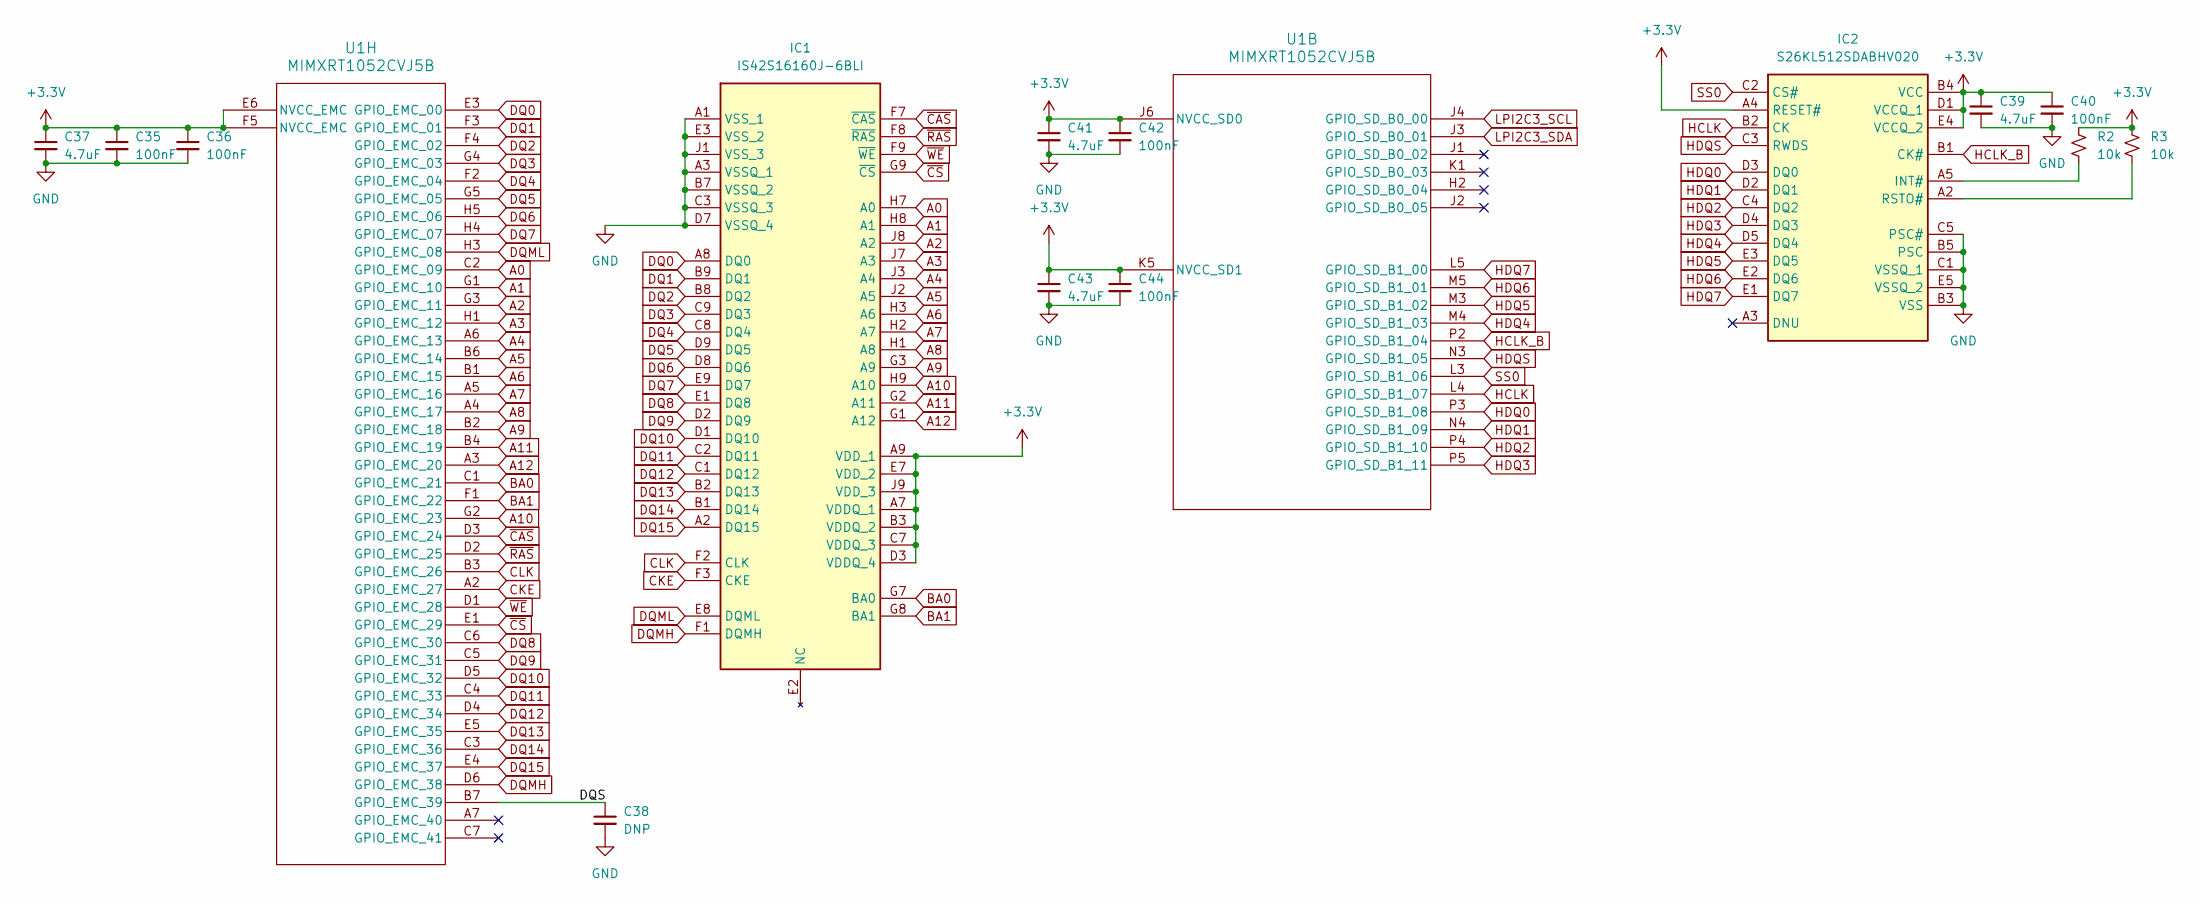
[picture p16: schematic flash.kicad_sch, Payload Board for Pleiades Atlas]

Parts:
C35, C36, C40, C42, C44: 100nF; C_0201_0603Metric
C37, C39, C41, C43: 4.7uF; C_0201_0603Metric
C38: DNP; C_0201_0603Metric
IC1: IS42S16160J-6BLI; BGA54C80P9X9_800X800X120; Mouser Part Number 870-42S16160J6BLI
IC2: S26KL512SDABHV020; BGA24C100P5X5_600X800X100; Mouser Part Number 727-26KS512SDPBHV020
R2, R3: 10k; R_0402_1005Metric
U1: MIMXRT1052CVJ5B; MAPBGA196_12X12

Connections:
/Flash & Memory/DQS: C38.1, U1.B7 (GPIO_EMC_39)
A0: IC1.H7 (A0), U1.C2 (GPIO_EMC_09)
A1: IC1.H8 (A1), U1.G1 (GPIO_EMC_10)
A2: IC1.J8 (A2), U1.G3 (GPIO_EMC_11)
A3: IC1.J7 (A3), U1.H1 (GPIO_EMC_12)
A4: IC1.J3 (A4), U1.A6 (GPIO_EMC_13)
A5: IC1.J2 (A5), U1.B6 (GPIO_EMC_14)
A6: IC1.H3 (A6), U1.B1 (GPIO_EMC_15)
A7: IC1.H2 (A7), U1.A5 (GPIO_EMC_16)
A8: IC1.H1 (A8), U1.A4 (GPIO_EMC_17)
A9: IC1.G3 (A9), U1.B2 (GPIO_EMC_18)
A10: IC1.H9 (A10), U1.G2 (GPIO_EMC_23)
A11: IC1.G2 (A11), U1.B4 (GPIO_EMC_19)
A12: IC1.G1 (A12), U1.A3 (GPIO_EMC_20)
BA0: IC1.G7 (BA0), U1.C1 (GPIO_EMC_21)
BA1: IC1.G8 (BA1), U1.F1 (GPIO_EMC_22)
CKE: IC1.F3 (CKE), U1.A2 (GPIO_EMC_27)
CLK: IC1.F2 (CLK), U1.B3 (GPIO_EMC_26)
DQ0: IC1.A8 (DQ0), U1.E3 (GPIO_EMC_00)
DQ1: IC1.B9 (DQ1), U1.F3 (GPIO_EMC_01)
DQ2: IC1.B8 (DQ2), U1.F4 (GPIO_EMC_02)
DQ3: IC1.C9 (DQ3), U1.G4 (GPIO_EMC_03)
DQ4: IC1.C8 (DQ4), U1.F2 (GPIO_EMC_04)
DQ5: IC1.D9 (DQ5), U1.G5 (GPIO_EMC_05)
DQ6: IC1.D8 (DQ6), U1.H5 (GPIO_EMC_06)
DQ7: IC1.E9 (DQ7), U1.H4 (GPIO_EMC_07)
DQ8: IC1.E1 (DQ8), U1.C6 (GPIO_EMC_30)
DQ9: IC1.D2 (DQ9), U1.C5 (GPIO_EMC_31)
DQ10: IC1.D1 (DQ10), U1.D5 (GPIO_EMC_32)
DQ11: IC1.C2 (DQ11), U1.C4 (GPIO_EMC_33)
DQ12: IC1.C1 (DQ12), U1.D4 (GPIO_EMC_34)
DQ13: IC1.B2 (DQ13), U1.E5 (GPIO_EMC_35)
DQ14: IC1.B1 (DQ14), U1.C3 (GPIO_EMC_36)
DQ15: IC1.A2 (DQ15), U1.E4 (GPIO_EMC_37)
DQMH: IC1.F1 (DQMH), U1.D6 (GPIO_EMC_38)
DQML: IC1.E8 (DQML), U1.H3 (GPIO_EMC_08)
GND: C35.2, C36.2, C37.2, C38.2, C39.2, C40.2, C41.2, C42.2, C43.2, C44.2, IC1.A1 (VSS_1), IC1.A3 (VSSQ_1), IC1.B7 (VSSQ_2), IC1.C3 (VSSQ_3), IC1.D7 (VSSQ_4), IC1.E3 (VSS_2), IC1.J1 (VSS_3), IC2.B3 (VSS), IC2.B5 (PSC), IC2.C1 (VSSQ_1), IC2.C5 (PSC#), IC2.E5 (VSSQ_2); also elsewhere on the board
HCLK: IC2.B2 (CK), U1.L4 (GPIO_SD_B1_07)
HCLK_B: IC2.B1 (CK#), U1.P2 (GPIO_SD_B1_04)
HDQ0: IC2.D3 (DQ0), U1.P3 (GPIO_SD_B1_08)
HDQ1: IC2.D2 (DQ1), U1.N4 (GPIO_SD_B1_09)
HDQ2: IC2.C4 (DQ2), U1.P4 (GPIO_SD_B1_10)
HDQ3: IC2.D4 (DQ3), U1.P5 (GPIO_SD_B1_11)
HDQ4: IC2.D5 (DQ4), U1.M4 (GPIO_SD_B1_03)
HDQ5: IC2.E3 (DQ5), U1.M3 (GPIO_SD_B1_02)
HDQ6: IC2.E2 (DQ6), U1.M5 (GPIO_SD_B1_01)
HDQ7: IC2.E1 (DQ7), U1.L5 (GPIO_SD_B1_00)
HDQS: IC2.C3 (RWDS), U1.N3 (GPIO_SD_B1_05)
LPI2C3_SCL: U1.J4 (GPIO_SD_B0_00); also elsewhere on the board
LPI2C3_SDA: U1.J3 (GPIO_SD_B0_01); also elsewhere on the board
unnamed: IC2.A5 (INT#), R2.2
unnamed: IC2.A2 (RSTO#), R3.2
SS0: IC2.C2 (CS#), U1.L3 (GPIO_SD_B1_06)
~CAS: IC1.F7 (~CAS), U1.D3 (GPIO_EMC_24)
~CS: IC1.G9 (~CS), U1.E1 (GPIO_EMC_29)
~RAS: IC1.F8 (~RAS), U1.D2 (GPIO_EMC_25)
~WE: IC1.F9 (~WE), U1.D1 (GPIO_EMC_28)

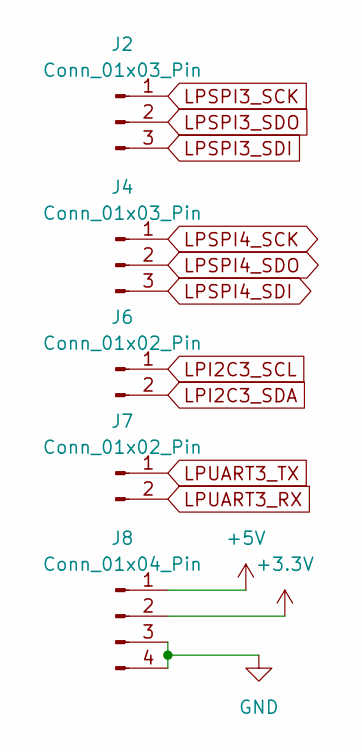
[picture p17: schematic connectors.kicad_sch, Payload Board for Pleiades Atlas]

Parts:
J2, J4: Conn_01x03_Pin; PinHeader_1x03_P2.54mm_Vertical
J6, J7: Conn_01x02_Pin; PinHeader_1x02_P2.54mm_Vertical
J8: Conn_01x04_Pin; PinHeader_1x04_P2.54mm_Vertical

Connections:
GND: J8.3, J8.4; also elsewhere on the board
GPIO_B0_08: J7.1; also elsewhere on the board
GPIO_B0_09: J7.2; also elsewhere on the board
LPI2C3_SCL: J6.1; also elsewhere on the board
LPI2C3_SDA: J6.2; also elsewhere on the board
LPSPI3_SCK: J2.1; also elsewhere on the board
LPSPI3_SDI: J2.3; also elsewhere on the board
LPSPI3_SDO: J2.2; also elsewhere on the board
LPSPI4_SCK: J4.1; also elsewhere on the board
LPSPI4_SDI: J4.3; also elsewhere on the board
LPSPI4_SDO: J4.2; also elsewhere on the board
VBUS: J8.1; also elsewhere on the board

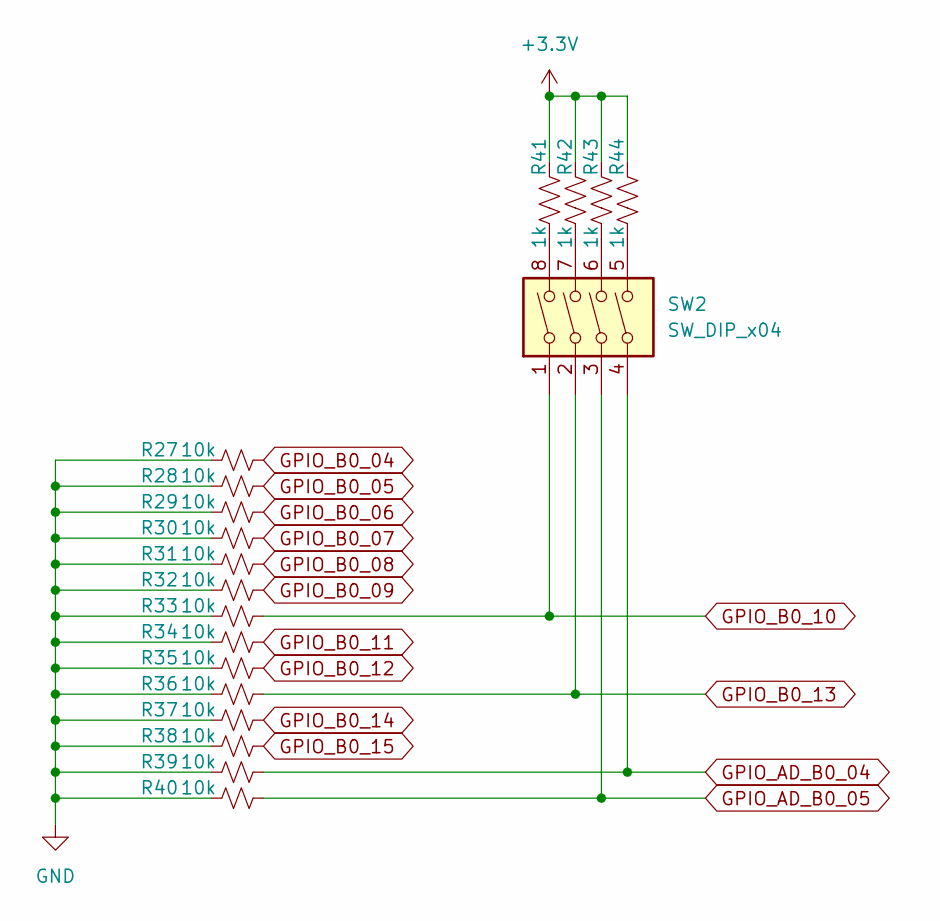
[picture p18: schematic bootconfig.kicad_sch, Payload Board for Pleiades Atlas]

Parts:
R27, R28, R29, R30, R31, R32, R33, R34, R35, R36, R37, R38, R39, R40: 10k; R_0402_1005Metric
R41, R42, R43, R44: 1k; R_0402_1005Metric
SW2: SW_DIP_x04; SW_DIP_SPSTx04_Slide_Copal_CHS-04A_W5.08mm_P1.27mm_JPin

Connections:
GND: R27.1, R28.1, R29.1, R30.1, R31.1, R32.1, R33.1, R34.1, R35.1, R36.1, R37.1, R38.1, R39.1, R40.1; also elsewhere on the board
GPIO_AD_B0_04: R39.2, SW2.4; also elsewhere on the board
GPIO_AD_B0_05: R40.2, SW2.3; also elsewhere on the board
GPIO_B0_04: R27.2; also elsewhere on the board
GPIO_B0_05: R28.2; also elsewhere on the board
GPIO_B0_06: R29.2; also elsewhere on the board
GPIO_B0_07: R30.2; also elsewhere on the board
GPIO_B0_08: R31.2; also elsewhere on the board
GPIO_B0_09: R32.2; also elsewhere on the board
GPIO_B0_10: R33.2, SW2.1; also elsewhere on the board
GPIO_B0_11: R34.2; also elsewhere on the board
GPIO_B0_12: R35.2; also elsewhere on the board
GPIO_B0_13: R36.2, SW2.2; also elsewhere on the board
GPIO_B0_14: R37.2; also elsewhere on the board
GPIO_B0_15: R38.2; also elsewhere on the board
unnamed: R41.2, SW2.8
unnamed: R42.2, SW2.7
unnamed: R43.2, SW2.6
unnamed: R44.2, SW2.5

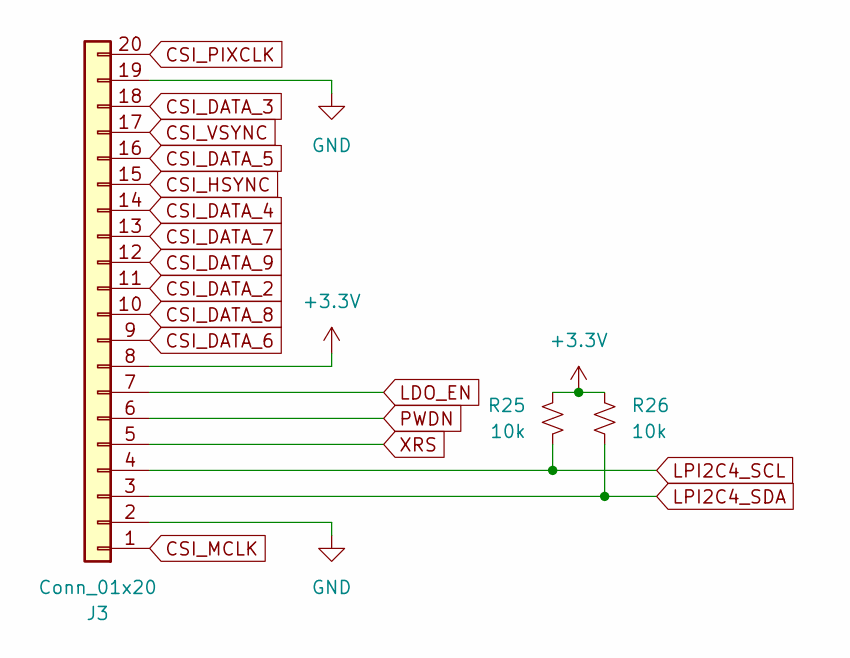
[picture p19: schematic csi.kicad_sch, Payload Board for Pleiades Atlas]

Parts:
J3: Conn_01x20; TE_2-1734839-0_1x20-1MP_P0.5mm_Horizontal
R25, R26: 10k; R_0402_1005Metric

Connections:
CSI_DATA_2: J3.11; also elsewhere on the board
CSI_DATA_3: J3.18; also elsewhere on the board
CSI_DATA_4: J3.14; also elsewhere on the board
CSI_DATA_5: J3.16; also elsewhere on the board
CSI_DATA_6: J3.9; also elsewhere on the board
CSI_DATA_7: J3.13; also elsewhere on the board
CSI_DATA_8: J3.10; also elsewhere on the board
CSI_DATA_9: J3.12; also elsewhere on the board
CSI_HSYNC: J3.15; also elsewhere on the board
CSI_MCLK: J3.1; also elsewhere on the board
CSI_PIXCLK: J3.20; also elsewhere on the board
CSI_VSYNC: J3.17; also elsewhere on the board
GND: J3.2, J3.19; also elsewhere on the board
LDO_EN: J3.7; also elsewhere on the board
LPI2C4_SCL: J3.4, R25.2; also elsewhere on the board
LPI2C4_SDA: J3.3, R26.2; also elsewhere on the board
PWDN: J3.6; also elsewhere on the board
XRS: J3.5; also elsewhere on the board

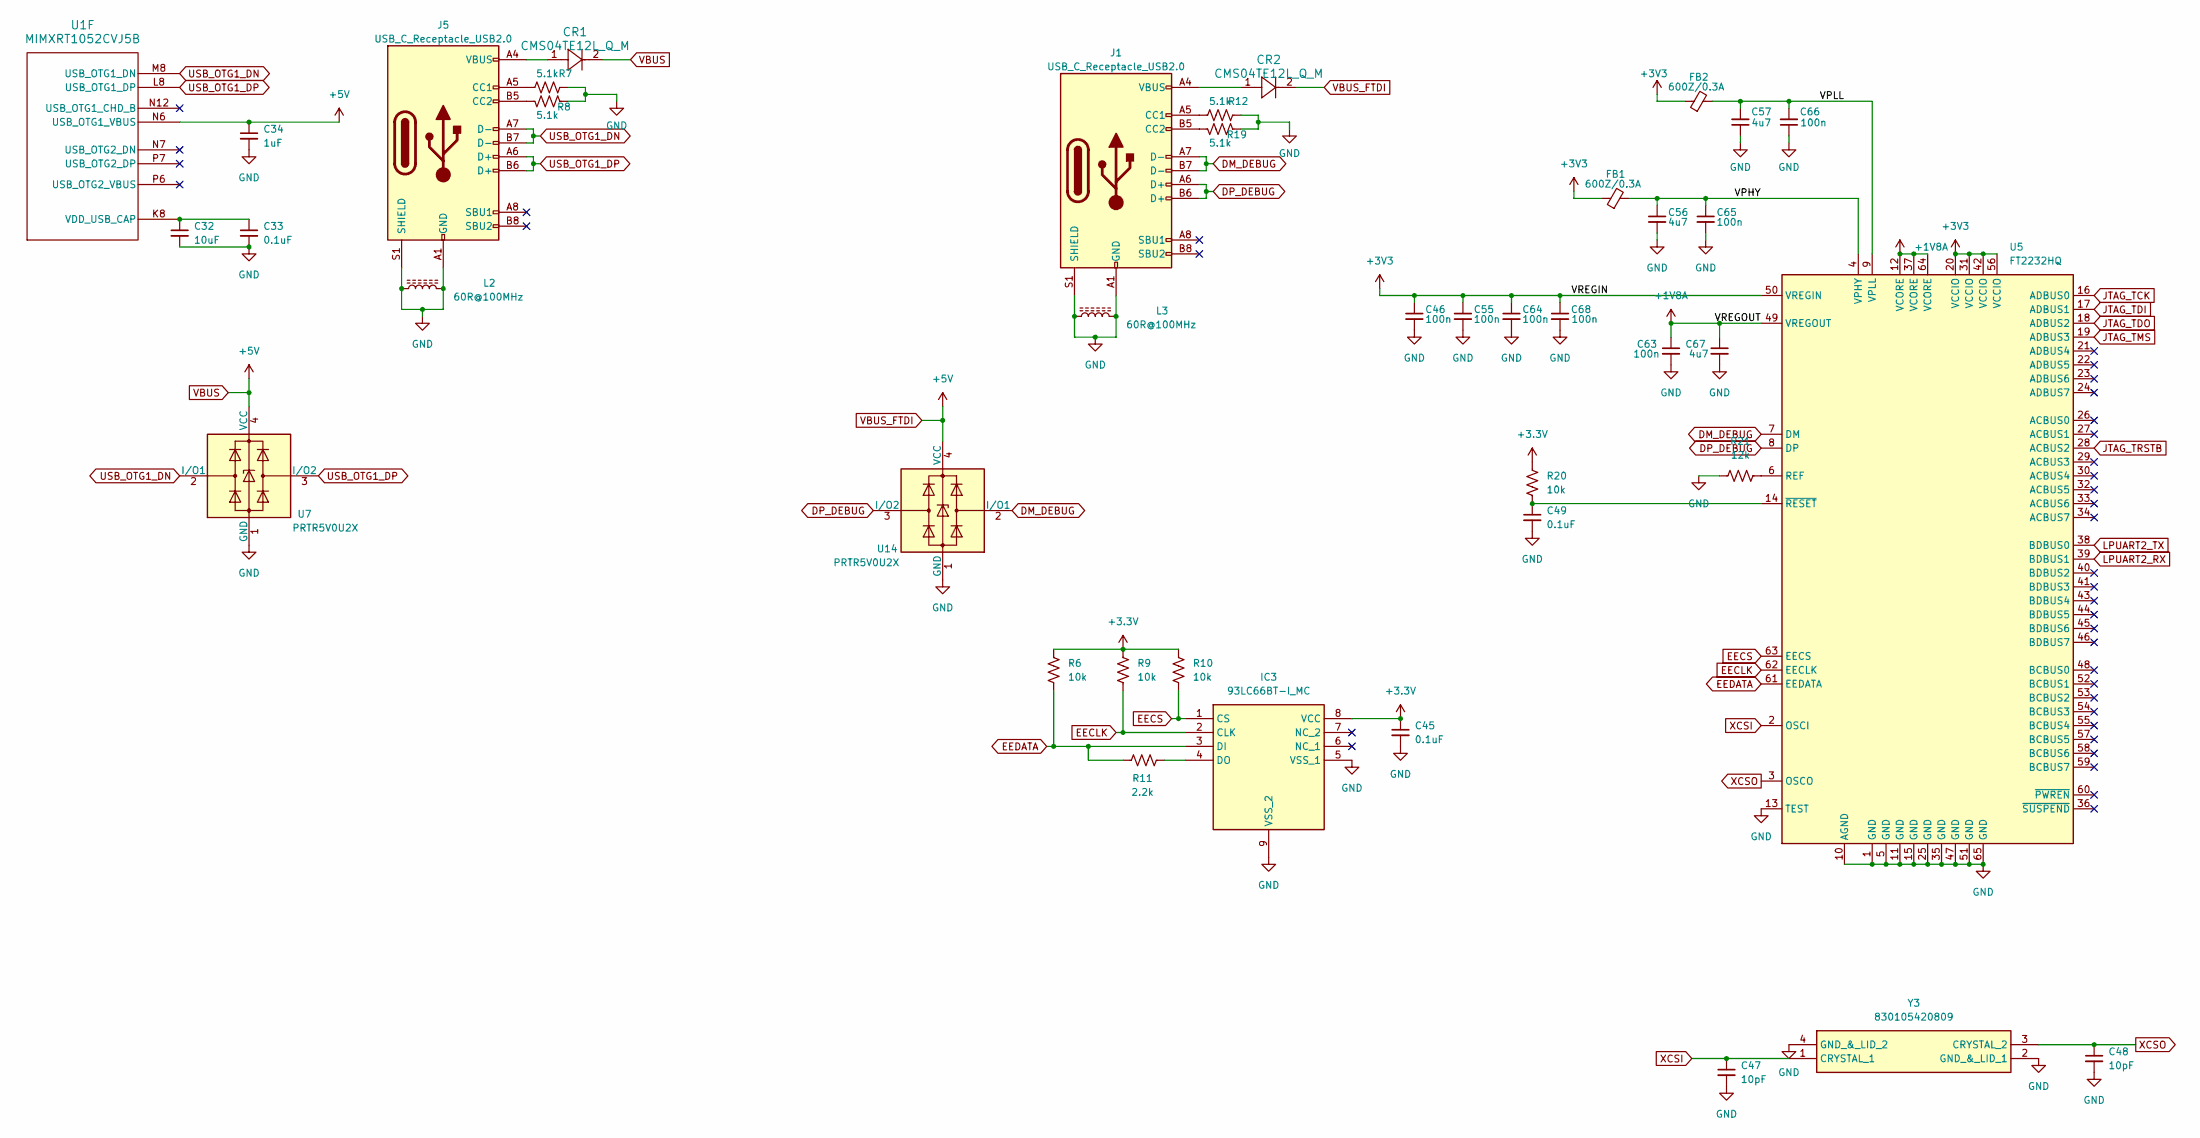
[picture p20: schematic usb_debug.kicad_sch, Payload Board for Pleiades Atlas]

Parts:
C32: 10uF; C_0402_1005Metric
C33, C45, C49: 0.1uF; C_0201_0603Metric
C34: 1uF; C_0201_0603Metric
C46, C55, C63, C64, C65, C66, C68: C_100n_16V_X7R_0402; C_0402_1005Metric; Voltage 16V; MPN C0402C104J4RAC7411
C47, C48: 10pF; C_0201_0603Metric
C56, C57, C67: C_4u7_0402; C_0402_1005Metric; MPN GRM155R61A475MEAAD
CR1, CR2: CMS04TE12L_Q_M; M-FLAT_TOS
FB1, FB2: FB_600Z_0.3A_Murata-BLM15AG_0402; L_0402_1005Metric; MPN BLM15AG601SN1D
IC3: 93LC66BT-I_MC; SON50P300X200X100-9N-D; Mouser Part Number 579-93LC66BT-I/MC
J1, J5: USB_C_Receptacle_USB2.0; USB_C_Receptacle_HRO_TYPE-C-31-M-12; JlcRotOffset 180
L2, L3: 60R@100MHz; L_1206_3216Metric; Manufacturer Part No MLB3216-600P4A(f); LCSC C33600
R6, R9, R10, R20: 10k; R_0402_1005Metric
R7, R8, R12, R19: 5.1k; R_0402_1005Metric
R11: 2.2k; R_0402_1005Metric
R21: 12k; R_0402_1005Metric
U1: MIMXRT1052CVJ5B; MAPBGA196_12X12
U5: FT2232HQ; QFN-64-1EP_9x9mm_P0.5mm_EP4.35x4.35mm
U7, U14: PRTR5V0U2X; SOT-143; LCSC C2827688
Y3: 830105420809; Mouser Part Number 710-830105420809

Connections:
+1V8A: C63.1, C67.1, U5.12 (VCORE), U5.37 (VCORE), U5.49 (VREGOUT), U5.64 (VCORE)
/USB & Debug/VPHY: C56.1, C65.1, FB1.2, U5.4 (VPHY)
/USB & Debug/VPLL: C57.2, C66.2, FB2.2, U5.9 (VPLL)
DM_DEBUG: J1.A7 (D-), J1.B7 (D-), U5.7 (DM), U14.2 (I/O1)
DP_DEBUG: J1.A6 (D+), J1.B6 (D+), U5.8 (DP), U14.3 (I/O2)
EECLK: IC3.2 (CLK), R9.2, U5.62 (EECLK)
EECS: IC3.1 (CS), R10.2, U5.63 (EECS)
EEDATA: IC3.3 (DI), R6.2, R11.1, U5.61 (EEDATA)
GND: C32.2, C33.2, C34.2, C45.2, C46.2, C47.2, C48.2, C49.2, C55.2, C56.2, C57.1, C63.2, C64.2, C65.2, C66.1, C67.2, C68.2, IC3.5 (VSS_1), IC3.9 (VSS_2), J1.A1 (GND), J1.A12 (GND), J1.B1 (GND), J1.B12 (GND), J1.S1 (SHIELD), J5.A1 (GND), J5.A12 (GND), J5.B1 (GND), J5.B12 (GND), J5.S1 (SHIELD), L2.1, L2.2, L3.1, L3.2, R7.1, R8.1, R12.1, R19.1, R21.1, U5.1 (GND), U5.5 (GND), U5.10 (AGND), U5.11 (GND), U5.13 (TEST), U5.15 (GND), U5.25 (GND), U5.35 (GND), U5.47 (GND), U5.51 (GND), U5.65 (GND), U7.1 (GND), U14.1 (GND), Y3.2 (GND_&_LID_1), Y3.4 (GND_&_LID_2); also elsewhere on the board
JTAG_TCK: U5.16 (ADBUS0); also elsewhere on the board
JTAG_TDI: U5.17 (ADBUS1); also elsewhere on the board
JTAG_TDO: U5.18 (ADBUS2); also elsewhere on the board
JTAG_TMS: U5.19 (ADBUS3); also elsewhere on the board
JTAG_TRSTB: U5.28 (ACBUS2); also elsewhere on the board
LPUART2_RX: U5.39 (BDBUS1); also elsewhere on the board
LPUART2_TX: U5.38 (BDBUS0); also elsewhere on the board
unnamed: CR1.1, J5.A4 (VBUS), J5.A9 (VBUS), J5.B4 (VBUS), J5.B9 (VBUS)
unnamed: CR2.1, J1.A4 (VBUS), J1.A9 (VBUS), J1.B4 (VBUS), J1.B9 (VBUS)
unnamed: IC3.4 (DO), R11.2
unnamed: J1.A5 (CC1), R12.2
unnamed: J1.B5 (CC2), R19.2
unnamed: J5.A5 (CC1), R7.2
unnamed: J5.B5 (CC2), R8.2
unnamed: C32.1, C33.1, U1.K8 (VDD_USB_CAP)
unnamed: R21.2, U5.6 (REF)
unnamed: C49.1, R20.2, U5.14 (~RESET)
USB_OTG1_DN: J5.A7 (D-), J5.B7 (D-), U1.M8 (USB_OTG1_DN), U7.2 (I/O1)
USB_OTG1_DP: J5.A6 (D+), J5.B6 (D+), U1.L8 (USB_OTG1_DP), U7.3 (I/O2)
VBUS: C34.1, CR1.2, CR2.2, U1.N6 (USB_OTG1_VBUS), U7.4 (VCC), U14.4 (VCC); also elsewhere on the board
XCSI: C47.1, U5.2 (OSCI), Y3.1 (CRYSTAL_1)
XCSO: C48.1, U5.3 (OSCO), Y3.3 (CRYSTAL_2)
