NU-Horizonsat/ADCS-Camera-Payload-Board/RT1050.kicad_pcb

## KiCad design RT1050.kicad_pcb (continued)

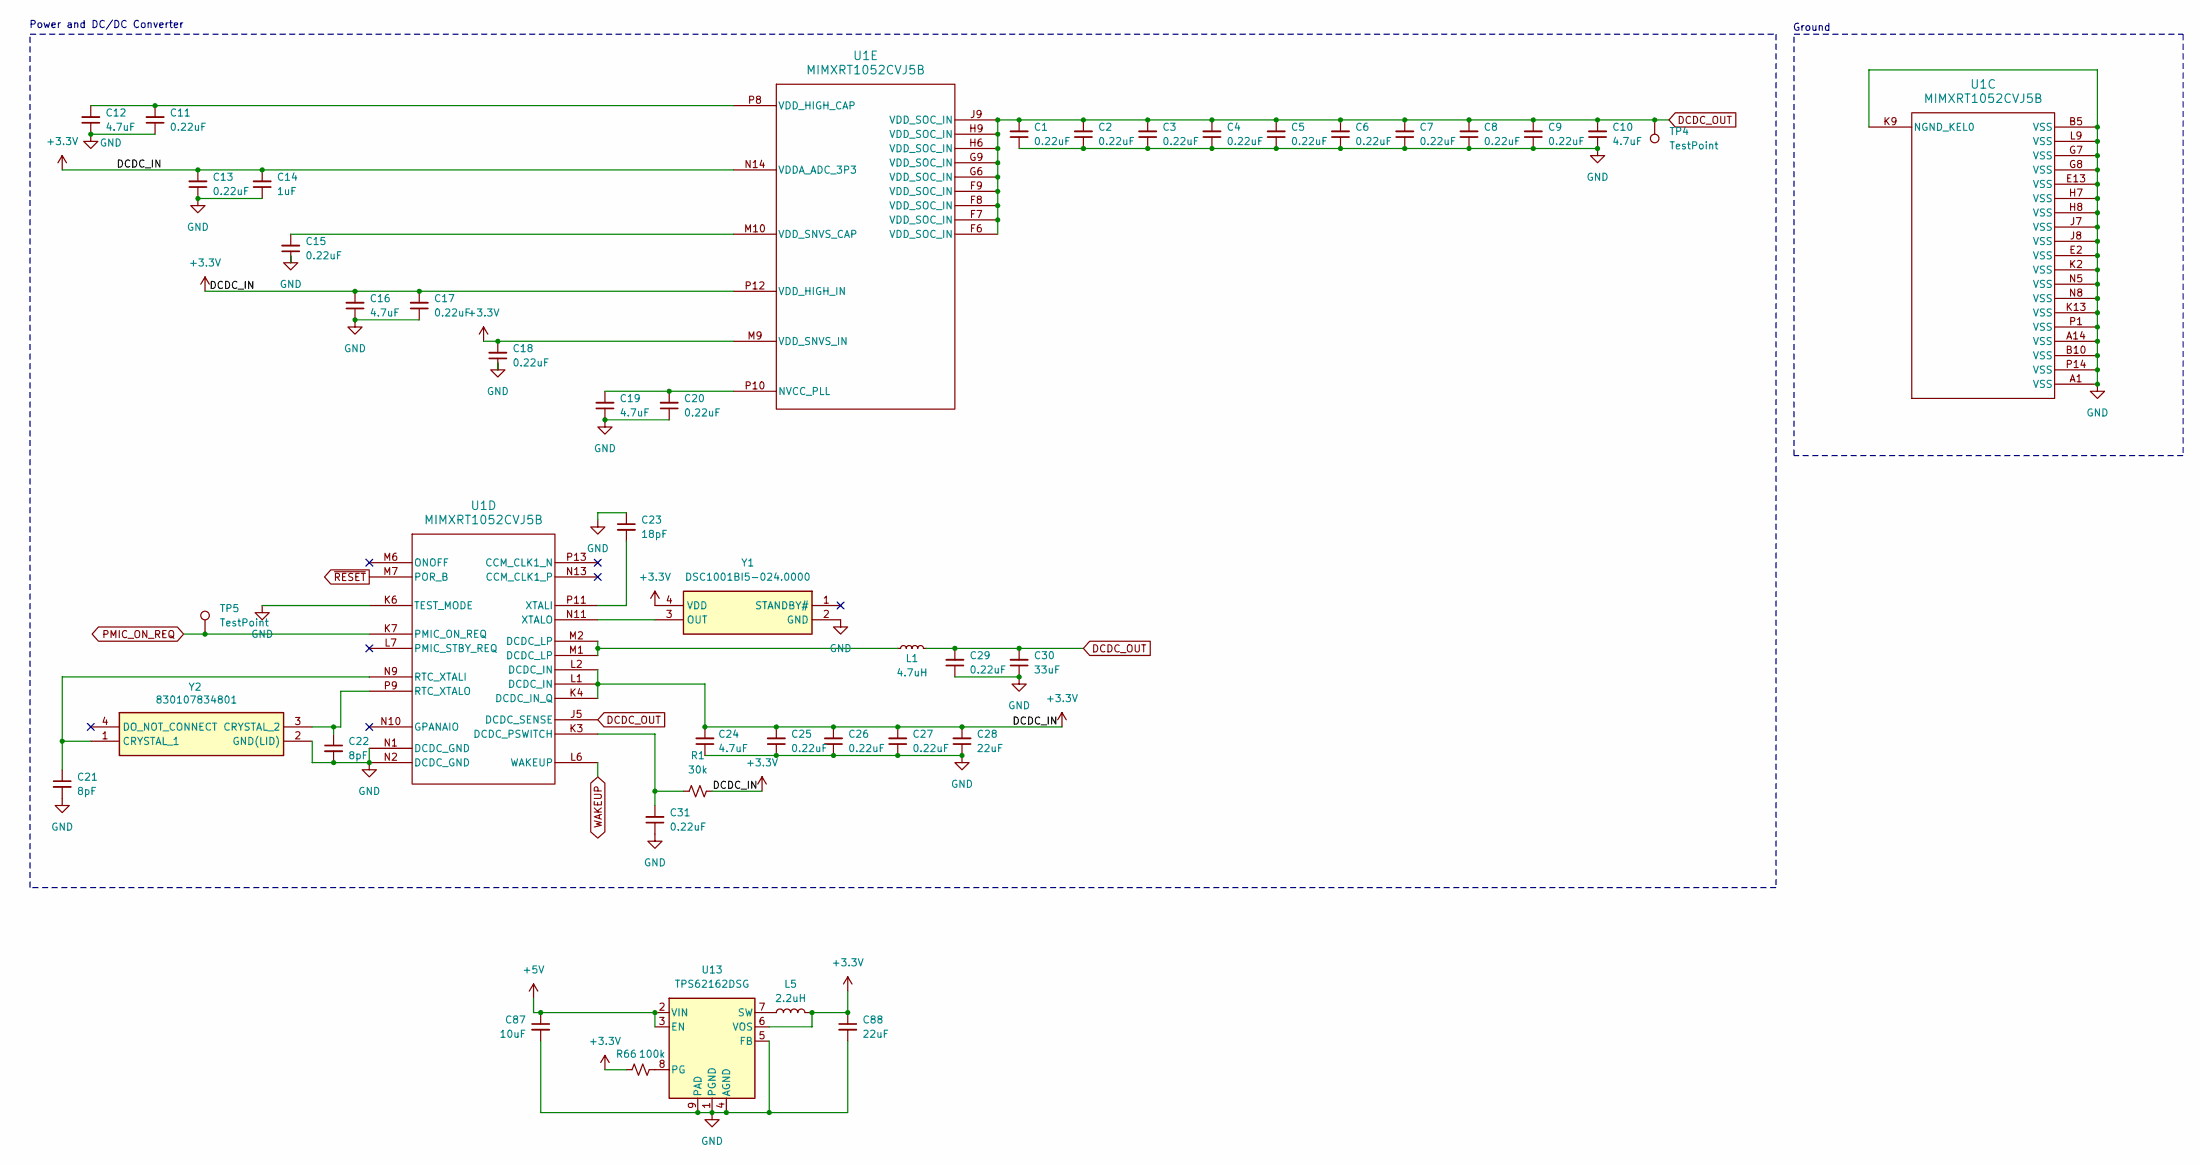
[picture p21: schematic mcu_power.kicad_sch, Payload Board for Pleiades Atlas]

Parts:
C1, C2, C3, C4, C5, C6, C7, C8, C9, C11, C13, C15, C17, C18, C20, C25, C26, C27, C29, C31: 0.22uF; C_0201_0603Metric
C10, C12, C16, C19, C24: 4.7uF; C_0201_0603Metric
C14: 1uF; C_0201_0603Metric
C21, C22: 8pF; C_0201_0603Metric
C23: 18pF; C_0201_0603Metric
C28, C88: 22uF; C_0603_1608Metric
C30: 33uF; C_0805_2012Metric
C87: 10uF; C_0402_1005Metric
L1: 4.7uH; L_0603_1608Metric
L5: 2.2uH; R_0402_1005Metric
R1: 30k; R_0402_1005Metric
R66: 100k; R_0402_1005Metric
TP4, TP5: TestPoint; TestPoint_Pad_D1.5mm
U1: MIMXRT1052CVJ5B; MAPBGA196_12X12
U13: TPS62162DSG; WSON-8-1EP_2x2mm_P0.5mm_EP0.9x1.6mm_ThermalVias
Y1: DSC1001BI5-024.0000; CDFN4_5X3P2_MCH; Mouser Part Number 579-001BI50240000
Y2: 830107834801; WE-XTAL_IQXC-146; Mouser Part Number 710-830107834801

Connections:
DCDC_OUT: C1.2, C2.2, C3.2, C4.2, C5.2, C6.2, C7.2, C8.2, C9.2, C10.2, C29.2, C30.2, L1.1, TP4.1, U1.F6 (VDD_SOC_IN), U1.F7 (VDD_SOC_IN), U1.F8 (VDD_SOC_IN), U1.F9 (VDD_SOC_IN), U1.G6 (VDD_SOC_IN), U1.G9 (VDD_SOC_IN), U1.H6 (VDD_SOC_IN), U1.H9 (VDD_SOC_IN), U1.J5 (DCDC_SENSE), U1.J9 (VDD_SOC_IN)
GND: C1.1, C2.1, C3.1, C4.1, C5.1, C6.1, C7.1, C8.1, C9.1, C10.1, C11.1, C12.1, C13.1, C14.1, C15.1, C16.1, C17.1, C18.1, C19.1, C20.1, C21.2, C22.2, C23.1, C24.1, C25.1, C26.1, C27.1, C28.1, C29.1, C30.1, C31.1, C87.2, C88.2, U1.A1 (VSS), U1.A14 (VSS), U1.B5 (VSS), U1.B10 (VSS), U1.E2 (VSS), U1.E13 (VSS), U1.G7 (VSS), U1.G8 (VSS), U1.H7 (VSS), U1.H8 (VSS), U1.J7 (VSS), U1.J8 (VSS), U1.K2 (VSS), U1.K6 (TEST_MODE), U1.K9 (NGND_KEL0), U1.K13 (VSS), U1.L9 (VSS), U1.N1 (DCDC_GND), U1.N2 (DCDC_GND), U1.N5 (VSS), U1.N8 (VSS), U1.P1 (VSS), U1.P14 (VSS), U13.1 (PGND), U13.4 (AGND), U13.5 (FB), U13.9 (PAD), Y1.2 (GND), Y2.2 (GND(LID)); also elsewhere on the board
unnamed: L1.2, U1.M1 (DCDC_LP), U1.M2 (DCDC_LP)
unnamed: C31.2, R1.1, U1.K3 (DCDC_PSWITCH)
unnamed: C21.1, U1.N9 (RTC_XTALI), Y2.1 (CRYSTAL_1)
unnamed: C22.1, U1.P9 (RTC_XTALO), Y2.3 (CRYSTAL_2)
unnamed: C23.2, U1.P11 (XTALI)
unnamed: U1.N11 (XTALO), Y1.3 (OUT)
unnamed: C19.2, C20.2, U1.P10 (NVCC_PLL)
unnamed: C11.2, C12.2, U1.P8 (VDD_HIGH_CAP)
unnamed: C15.2, U1.M10 (VDD_SNVS_CAP)
unnamed: R66.2, U13.8 (PG)
unnamed: L5.1, U13.7 (SW)
PMIC_ON_REQ: TP5.1, U1.K7 (PMIC_ON_REQ)
VBUS: C87.1, U13.2 (VIN), U13.3 (EN); also elsewhere on the board
WAKEUP: U1.L6 (WAKEUP)
~RESET: U1.M7 (POR_B); also elsewhere on the board

Notes on the sheet:
Power and DC/DC Converter
Ground

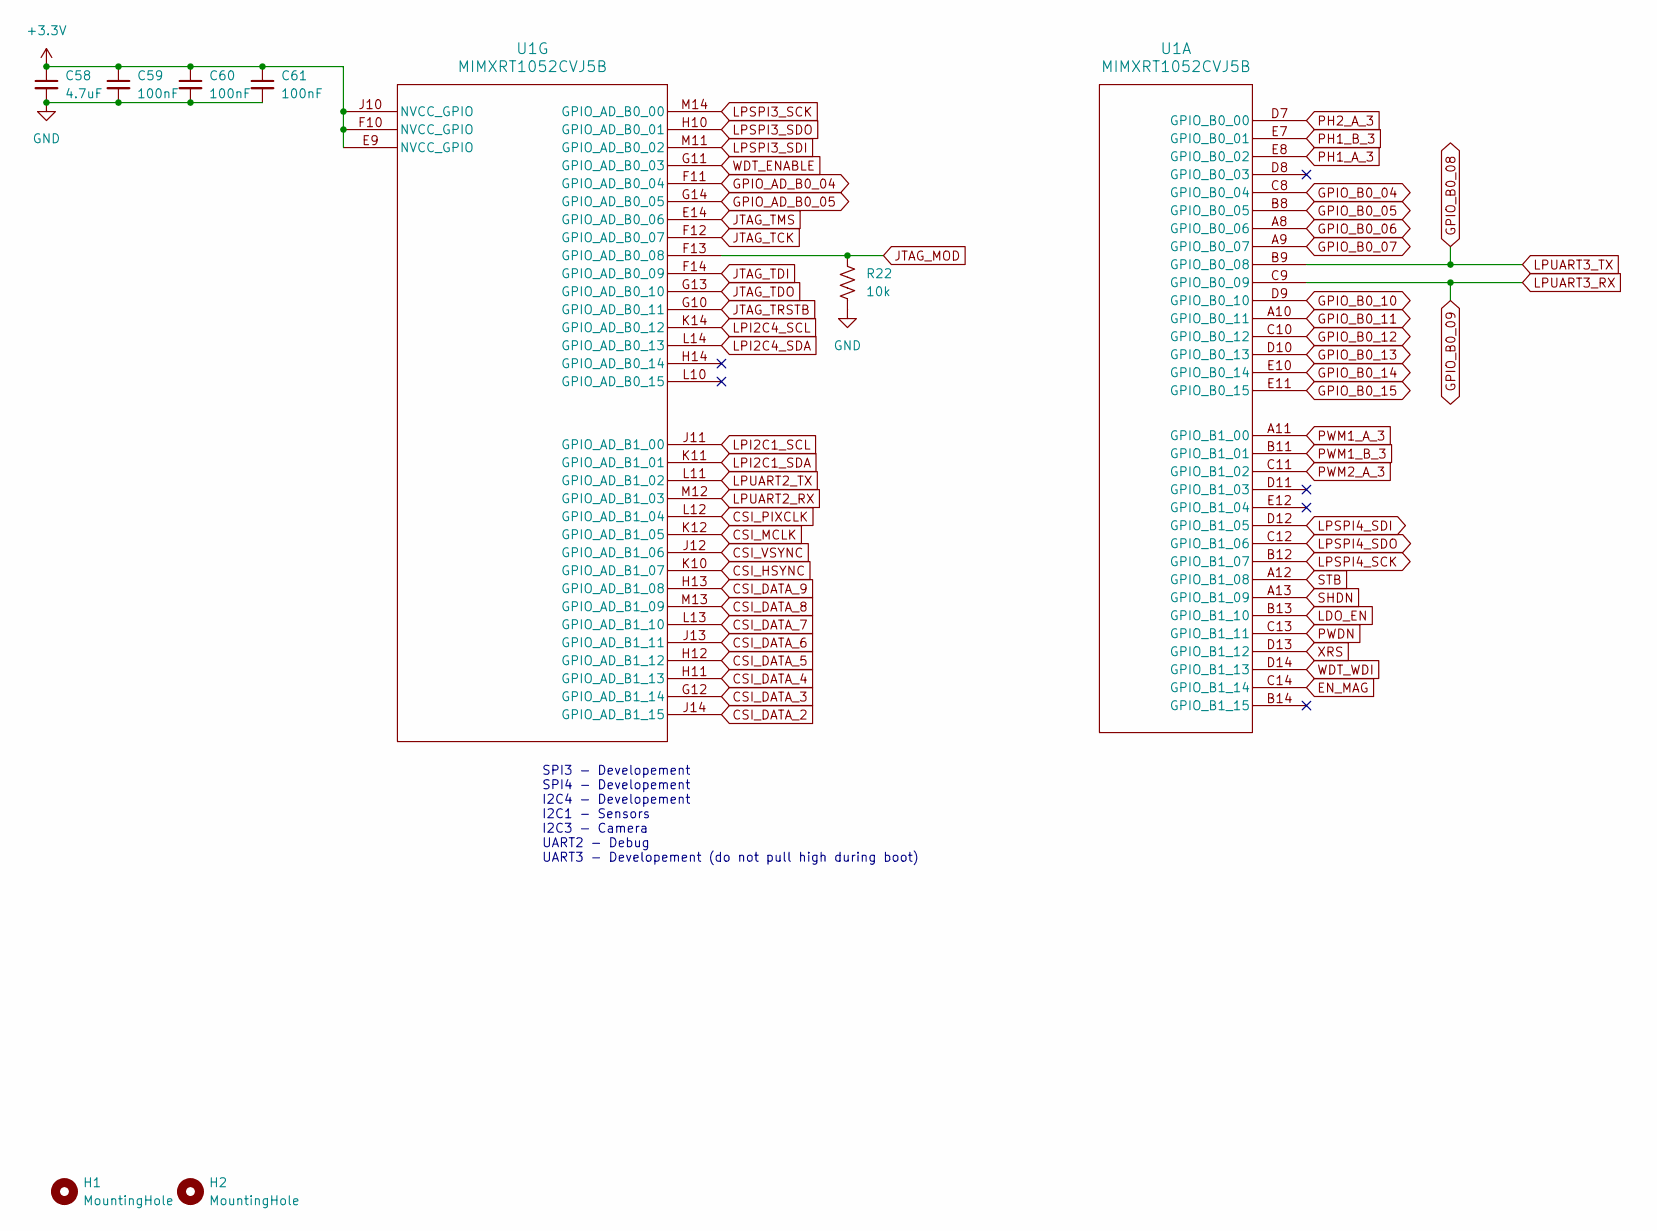
[picture p22: schematic mcu.kicad_sch, Payload Board for Pleiades Atlas]

Parts:
C58: 4.7uF; C_0201_0603Metric
C59, C60, C61: 100nF; C_0201_0603Metric
H1, H2: MountingHole
R22: 10k; R_0402_1005Metric
U1: MIMXRT1052CVJ5B; MAPBGA196_12X12

Connections:
CSI_DATA_2: U1.J14 (GPIO_AD_B1_15); also elsewhere on the board
CSI_DATA_3: U1.G12 (GPIO_AD_B1_14); also elsewhere on the board
CSI_DATA_4: U1.H11 (GPIO_AD_B1_13); also elsewhere on the board
CSI_DATA_5: U1.H12 (GPIO_AD_B1_12); also elsewhere on the board
CSI_DATA_6: U1.J13 (GPIO_AD_B1_11); also elsewhere on the board
CSI_DATA_7: U1.L13 (GPIO_AD_B1_10); also elsewhere on the board
CSI_DATA_8: U1.M13 (GPIO_AD_B1_09); also elsewhere on the board
CSI_DATA_9: U1.H13 (GPIO_AD_B1_08); also elsewhere on the board
CSI_HSYNC: U1.K10 (GPIO_AD_B1_07); also elsewhere on the board
CSI_MCLK: U1.K12 (GPIO_AD_B1_05); also elsewhere on the board
CSI_PIXCLK: U1.L12 (GPIO_AD_B1_04); also elsewhere on the board
CSI_VSYNC: U1.J12 (GPIO_AD_B1_06); also elsewhere on the board
EN_MAG: U1.C14 (GPIO_B1_14); also elsewhere on the board
GND: C58.2, C59.2, C60.2, C61.2, R22.2; also elsewhere on the board
GPIO_AD_B0_04: U1.F11 (GPIO_AD_B0_04); also elsewhere on the board
GPIO_AD_B0_05: U1.G14 (GPIO_AD_B0_05); also elsewhere on the board
GPIO_B0_04: U1.C8 (GPIO_B0_04); also elsewhere on the board
GPIO_B0_05: U1.B8 (GPIO_B0_05); also elsewhere on the board
GPIO_B0_06: U1.A8 (GPIO_B0_06); also elsewhere on the board
GPIO_B0_07: U1.A9 (GPIO_B0_07); also elsewhere on the board
GPIO_B0_08: U1.B9 (GPIO_B0_08); also elsewhere on the board
GPIO_B0_09: U1.C9 (GPIO_B0_09); also elsewhere on the board
GPIO_B0_10: U1.D9 (GPIO_B0_10); also elsewhere on the board
GPIO_B0_11: U1.A10 (GPIO_B0_11); also elsewhere on the board
GPIO_B0_12: U1.C10 (GPIO_B0_12); also elsewhere on the board
GPIO_B0_13: U1.D10 (GPIO_B0_13); also elsewhere on the board
GPIO_B0_14: U1.E10 (GPIO_B0_14); also elsewhere on the board
GPIO_B0_15: U1.E11 (GPIO_B0_15); also elsewhere on the board
JTAG_MOD: R22.1, U1.F13 (GPIO_AD_B0_08)
JTAG_TCK: U1.F12 (GPIO_AD_B0_07); also elsewhere on the board
JTAG_TDI: U1.F14 (GPIO_AD_B0_09); also elsewhere on the board
JTAG_TDO: U1.G13 (GPIO_AD_B0_10); also elsewhere on the board
JTAG_TMS: U1.E14 (GPIO_AD_B0_06); also elsewhere on the board
JTAG_TRSTB: U1.G10 (GPIO_AD_B0_11); also elsewhere on the board
LDO_EN: U1.B13 (GPIO_B1_10); also elsewhere on the board
LPI2C1_SCL: U1.J11 (GPIO_AD_B1_00); also elsewhere on the board
LPI2C1_SDA: U1.K11 (GPIO_AD_B1_01); also elsewhere on the board
LPI2C4_SCL: U1.K14 (GPIO_AD_B0_12); also elsewhere on the board
LPI2C4_SDA: U1.L14 (GPIO_AD_B0_13); also elsewhere on the board
LPSPI3_SCK: U1.M14 (GPIO_AD_B0_00); also elsewhere on the board
LPSPI3_SDI: U1.M11 (GPIO_AD_B0_02); also elsewhere on the board
LPSPI3_SDO: U1.H10 (GPIO_AD_B0_01); also elsewhere on the board
LPSPI4_SCK: U1.B12 (GPIO_B1_07); also elsewhere on the board
LPSPI4_SDI: U1.D12 (GPIO_B1_05); also elsewhere on the board
LPSPI4_SDO: U1.C12 (GPIO_B1_06); also elsewhere on the board
LPUART2_RX: U1.M12 (GPIO_AD_B1_03); also elsewhere on the board
LPUART2_TX: U1.L11 (GPIO_AD_B1_02); also elsewhere on the board
PH1_A_3: U1.E8 (GPIO_B0_02); also elsewhere on the board
PH1_B_3: U1.E7 (GPIO_B0_01); also elsewhere on the board
PH2_A_3: U1.D7 (GPIO_B0_00); also elsewhere on the board
PWDN: U1.C13 (GPIO_B1_11); also elsewhere on the board
PWM1_A_3: U1.A11 (GPIO_B1_00); also elsewhere on the board
PWM1_B_3: U1.B11 (GPIO_B1_01); also elsewhere on the board
PWM2_A_3: U1.C11 (GPIO_B1_02); also elsewhere on the board
SHDN: U1.A13 (GPIO_B1_09)
STB: U1.A12 (GPIO_B1_08)
WDT_ENABLE: U1.G11 (GPIO_AD_B0_03); also elsewhere on the board
WDT_WDI: U1.D14 (GPIO_B1_13); also elsewhere on the board
XRS: U1.D13 (GPIO_B1_12); also elsewhere on the board

Notes on the sheet:
SPI3 - Developement SPI4 - Developement I2C4 - Developement I2C1 - Sensors I2C3 - Camera UART2 - Debug UART3 - Developement (do not pull high during boot)

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
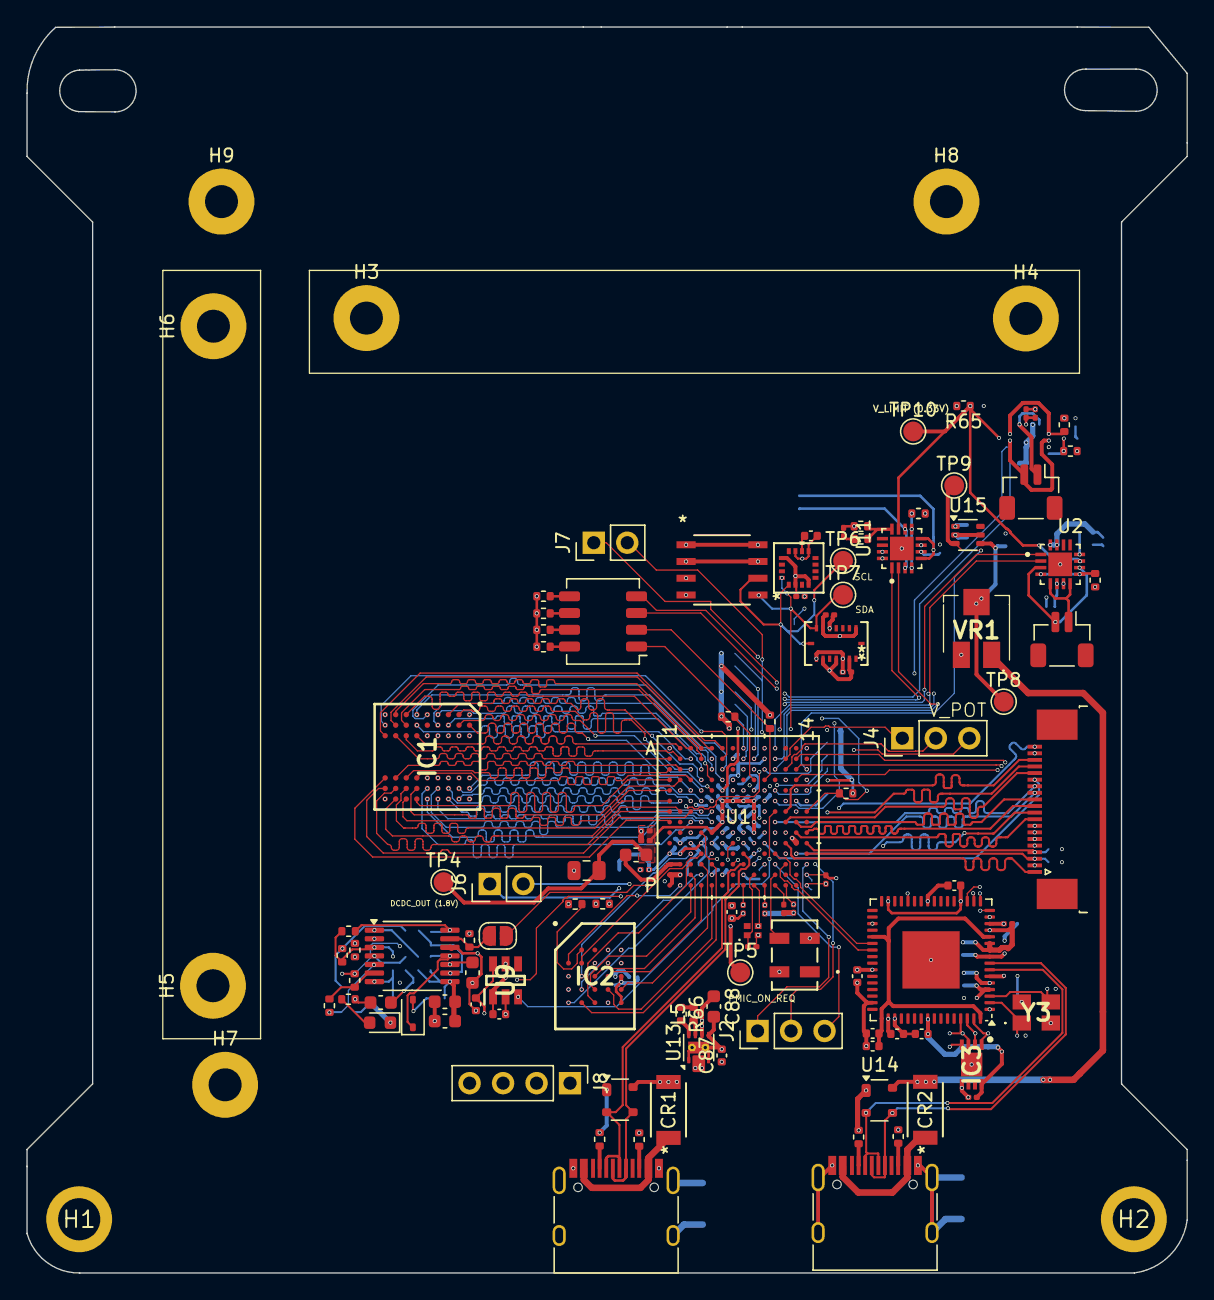
[picture p23: board RT1050.kicad_pcb from above]

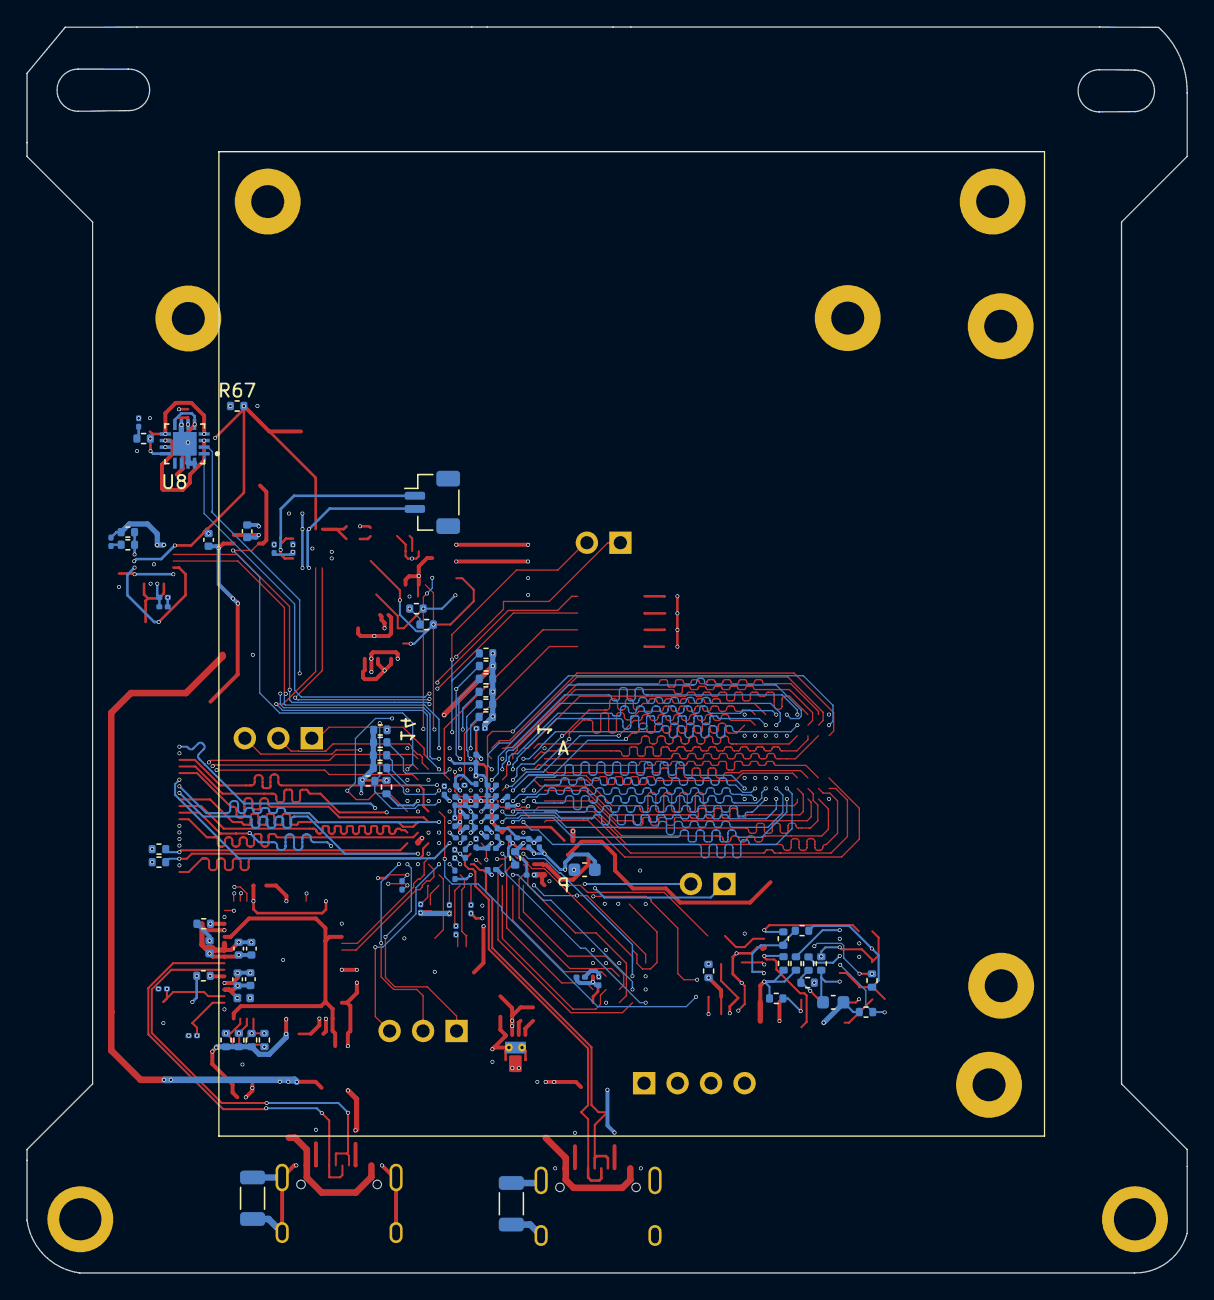
[picture p24: board RT1050.kicad_pcb from below]

Board: 4 copper layers, 88.0 x 94.5 mm, 212 parts (96 on the bottom side), 191 nets.
