NU-Horizonsat/ADCS-Camera-Payload-Board/board/pin_mux.c

/***********************************************************************************************************************
 * This file was generated by the MCUXpresso Config Tools. Any manual edits made to this file
 * will be overwritten if the respective MCUXpresso Config Tools is used to update this file.
 **********************************************************************************************************************/

/*
 * TEXT BELOW IS USED AS SETTING FOR TOOLS *************************************
!!GlobalInfo
product: Pins v16.0
processor: MIMXRT1052xxxxB
package_id: MIMXRT1052DVL6B
mcu_data: ksdk2_0
processor_version: 16.3.0
 * BE CAREFUL MODIFYING THIS COMMENT - IT IS YAML SETTINGS FOR TOOLS ***********
 */

#include "fsl_common.h"
#include "fsl_iomuxc.h"
#include "pin_mux.h"

/* FUNCTION ************************************************************************************************************
 * 
 * Function Name : BOARD_InitBootPins
 * Description   : Calls initialization functions.
 * 
 * END ****************************************************************************************************************/
void BOARD_InitBootPins(void) {
}

/*
 * TEXT BELOW IS USED AS SETTING FOR TOOLS *************************************
BOARD_InitPins:
- options: {callFromInitBoot: 'false', coreID: core0, enableClock: 'true'}
- pin_list:
  - {pin_num: J14, peripheral: CSI, signal: 'csi_data, 02', pin_signal: GPIO_AD_B1_15}
  - {pin_num: F13, peripheral: CSI, signal: 'csi_data, 05', pin_signal: GPIO_AD_B0_08}
  - {pin_num: J13, peripheral: CSI, signal: 'csi_data, 06', pin_signal: GPIO_AD_B1_11}
  - {pin_num: G14, peripheral: CSI, signal: 'csi_data, 08', pin_signal: GPIO_AD_B0_05}
  - {pin_num: H13, peripheral: CSI, signal: 'csi_data, 09', pin_signal: GPIO_AD_B1_08}
  - {pin_num: J12, peripheral: CSI, signal: csi_vsync, pin_signal: GPIO_AD_B1_06}
  - {pin_num: L12, peripheral: CSI, signal: csi_pixclk, pin_signal: GPIO_AD_B1_04}
  - {pin_num: K12, peripheral: CSI, signal: csi_mclk, pin_signal: GPIO_AD_B1_05}
  - {pin_num: K10, peripheral: CSI, signal: csi_hsync, pin_signal: GPIO_AD_B1_07}
  - {pin_num: P3, peripheral: FLEXSPI, signal: FLEXSPI_A_DATA0, pin_signal: GPIO_SD_B1_08}
  - {pin_num: N4, peripheral: FLEXSPI, signal: FLEXSPI_A_DATA1, pin_signal: GPIO_SD_B1_09}
  - {pin_num: L3, peripheral: FLEXSPI, signal: FLEXSPI_A_SS0_B, pin_signal: GPIO_SD_B1_06}
  - {pin_num: L4, peripheral: FLEXSPI, signal: FLEXSPI_A_SCLK, pin_signal: GPIO_SD_B1_07}
  - {pin_num: N3, peripheral: FLEXSPI, signal: FLEXSPI_A_DQS, pin_signal: GPIO_SD_B1_05}
  - {pin_num: P4, peripheral: FLEXSPI, signal: FLEXSPI_A_DATA2, pin_signal: GPIO_SD_B1_10}
  - {pin_num: P5, peripheral: FLEXSPI, signal: FLEXSPI_A_DATA3, pin_signal: GPIO_SD_B1_11}
  - {pin_num: M3, peripheral: FLEXSPI, signal: FLEXSPI_B_DATA1, pin_signal: GPIO_SD_B1_02}
  - {pin_num: M5, peripheral: FLEXSPI, signal: FLEXSPI_B_DATA2, pin_signal: GPIO_SD_B1_01}
  - {pin_num: L5, peripheral: FLEXSPI, signal: FLEXSPI_B_DATA3, pin_signal: GPIO_SD_B1_00}
  - {pin_num: P2, peripheral: FLEXSPI, signal: FLEXSPI_B_SCLK, pin_signal: GPIO_SD_B1_04}
  - {pin_num: J11, peripheral: LPI2C1, signal: SCL, pin_signal: GPIO_AD_B1_00}
  - {pin_num: K11, peripheral: LPI2C1, signal: SDA, pin_signal: GPIO_AD_B1_01}
  - {pin_num: C8, peripheral: LPI2C2, signal: SCL, pin_signal: GPIO_B0_04}
  - {pin_num: B8, peripheral: LPI2C2, signal: SDA, pin_signal: GPIO_B0_05}
  - {pin_num: L14, peripheral: LPI2C4, signal: SDA, pin_signal: GPIO_AD_B0_13}
  - {pin_num: K14, peripheral: LPI2C4, signal: SCL, pin_signal: GPIO_AD_B0_12}
  - {pin_num: M14, peripheral: LPSPI3, signal: SCK, pin_signal: GPIO_AD_B0_00}
  - {pin_num: M11, peripheral: LPSPI3, signal: SDI, pin_signal: GPIO_AD_B0_02}
  - {pin_num: M12, peripheral: LPUART2, signal: RX, pin_signal: GPIO_AD_B1_03}
  - {pin_num: L11, peripheral: LPUART2, signal: TX, pin_signal: GPIO_AD_B1_02}
  - {pin_num: C2, peripheral: SEMC, signal: 'ADDR, 00', pin_signal: GPIO_EMC_09}
  - {pin_num: G1, peripheral: SEMC, signal: 'ADDR, 01', pin_signal: GPIO_EMC_10}
  - {pin_num: G3, peripheral: SEMC, signal: 'ADDR, 02', pin_signal: GPIO_EMC_11}
  - {pin_num: H1, peripheral: SEMC, signal: 'ADDR, 03', pin_signal: GPIO_EMC_12}
  - {pin_num: A6, peripheral: SEMC, signal: 'ADDR, 04', pin_signal: GPIO_EMC_13}
  - {pin_num: B6, peripheral: SEMC, signal: 'ADDR, 05', pin_signal: GPIO_EMC_14}
  - {pin_num: B1, peripheral: SEMC, signal: 'ADDR, 06', pin_signal: GPIO_EMC_15}
  - {pin_num: A5, peripheral: SEMC, signal: 'ADDR, 07', pin_signal: GPIO_EMC_16}
  - {pin_num: A4, peripheral: SEMC, signal: 'ADDR, 08', pin_signal: GPIO_EMC_17}
  - {pin_num: B2, peripheral: SEMC, signal: 'ADDR, 09', pin_signal: GPIO_EMC_18}
  - {pin_num: G2, peripheral: SEMC, signal: 'ADDR, 10', pin_signal: GPIO_EMC_23}
  - {pin_num: B4, peripheral: SEMC, signal: 'ADDR, 11', pin_signal: GPIO_EMC_19}
  - {pin_num: A3, peripheral: SEMC, signal: 'ADDR, 12', pin_signal: GPIO_EMC_20}
  - {pin_num: C1, peripheral: SEMC, signal: 'BA, 0', pin_signal: GPIO_EMC_21}
  - {pin_num: F1, peripheral: SEMC, signal: 'BA, 1', pin_signal: GPIO_EMC_22}
  - {pin_num: D3, peripheral: SEMC, signal: semc_cas, pin_signal: GPIO_EMC_24}
  - {pin_num: A2, peripheral: SEMC, signal: semc_cke, pin_signal: GPIO_EMC_27}
  - {pin_num: B3, peripheral: SEMC, signal: semc_clk, pin_signal: GPIO_EMC_26}
  - {pin_num: C7, peripheral: SEMC, signal: 'CSX, 0', pin_signal: GPIO_EMC_41}
  - {pin_num: E3, peripheral: SEMC, signal: 'DATA, 00', pin_signal: GPIO_EMC_00}
  - {pin_num: F3, peripheral: SEMC, signal: 'DATA, 01', pin_signal: GPIO_EMC_01}
  - {pin_num: F4, peripheral: SEMC, signal: 'DATA, 02', pin_signal: GPIO_EMC_02}
  - {pin_num: G4, peripheral: SEMC, signal: 'DATA, 03', pin_signal: GPIO_EMC_03}
  - {pin_num: F2, peripheral: SEMC, signal: 'DATA, 04', pin_signal: GPIO_EMC_04}
  - {pin_num: G5, peripheral: SEMC, signal: 'DATA, 05', pin_signal: GPIO_EMC_05}
  - {pin_num: H5, peripheral: SEMC, signal: 'DATA, 06', pin_signal: GPIO_EMC_06}
  - {pin_num: H4, peripheral: SEMC, signal: 'DATA, 07', pin_signal: GPIO_EMC_07}
  - {pin_num: C6, peripheral: SEMC, signal: 'DATA, 08', pin_signal: GPIO_EMC_30}
  - {pin_num: C5, peripheral: SEMC, signal: 'DATA, 09', pin_signal: GPIO_EMC_31}
  - {pin_num: D5, peripheral: SEMC, signal: 'DATA, 10', pin_signal: GPIO_EMC_32}
  - {pin_num: C4, peripheral: SEMC, signal: 'DATA, 11', pin_signal: GPIO_EMC_33}
  - {pin_num: D4, peripheral: SEMC, signal: 'DATA, 12', pin_signal: GPIO_EMC_34}
  - {pin_num: E5, peripheral: SEMC, signal: 'DATA, 13', pin_signal: GPIO_EMC_35}
  - {pin_num: C3, peripheral: SEMC, signal: 'DATA, 14', pin_signal: GPIO_EMC_36}
  - {pin_num: E4, peripheral: SEMC, signal: 'DATA, 15', pin_signal: GPIO_EMC_37}
  - {pin_num: H3, peripheral: SEMC, signal: 'DM, 0', pin_signal: GPIO_EMC_08}
  - {pin_num: D6, peripheral: SEMC, signal: 'DM, 1', pin_signal: GPIO_EMC_38}
  - {pin_num: D2, peripheral: SEMC, signal: semc_ras, pin_signal: GPIO_EMC_25}
  - {pin_num: D1, peripheral: SEMC, signal: semc_we, pin_signal: GPIO_EMC_28}
  - {pin_num: J3, peripheral: USDHC1, signal: usdhc_clk, pin_signal: GPIO_SD_B0_01}
  - {pin_num: J1, peripheral: USDHC1, signal: 'usdhc_data, 0', pin_signal: GPIO_SD_B0_02}
  - {pin_num: K1, peripheral: USDHC1, signal: 'usdhc_data, 1', pin_signal: GPIO_SD_B0_03}
  - {pin_num: H2, peripheral: USDHC1, signal: 'usdhc_data, 2', pin_signal: GPIO_SD_B0_04}
  - {pin_num: J2, peripheral: USDHC1, signal: 'usdhc_data, 3', pin_signal: GPIO_SD_B0_05}
  - {pin_num: J4, peripheral: USDHC1, signal: usdhc_cmd, pin_signal: GPIO_SD_B0_00}
  - {pin_num: A11, peripheral: PWM1, signal: 'A, 3', pin_signal: GPIO_B1_00}
  - {pin_num: B11, peripheral: PWM1, signal: 'B, 3', pin_signal: GPIO_B1_01}
  - {pin_num: C11, peripheral: PWM2, signal: 'A, 3', pin_signal: GPIO_B1_02}
  - {pin_num: D11, peripheral: PWM2, signal: 'B, 3', pin_signal: GPIO_B1_03}
  - {pin_num: E14, peripheral: JTAG, signal: TMS, pin_signal: GPIO_AD_B0_06}
  - {pin_num: G13, peripheral: JTAG, signal: TDO, pin_signal: GPIO_AD_B0_10}
  - {pin_num: F14, peripheral: JTAG, signal: TDI, pin_signal: GPIO_AD_B0_09}
  - {pin_num: F12, peripheral: JTAG, signal: TCK, pin_signal: GPIO_AD_B0_07}
  - {pin_num: G10, peripheral: JTAG, signal: TRSTB, pin_signal: GPIO_AD_B0_11}
  - {pin_num: L13, peripheral: CSI, signal: 'csi_data, 07', pin_signal: GPIO_AD_B1_10}
  - {pin_num: H11, peripheral: CSI, signal: 'csi_data, 04', pin_signal: GPIO_AD_B1_13}
  - {pin_num: G12, peripheral: CSI, signal: 'csi_data, 03', pin_signal: GPIO_AD_B1_14}
  - {pin_num: H10, peripheral: LPSPI3, signal: SDO, pin_signal: GPIO_AD_B0_01}
  - {pin_num: B7, peripheral: WDOG1, signal: wdog_b, pin_signal: GPIO_EMC_39}
 * BE CAREFUL MODIFYING THIS COMMENT - IT IS YAML SETTINGS FOR TOOLS ***********
 */

/* FUNCTION ************************************************************************************************************
 *
 * Function Name : BOARD_InitPins
 * Description   : Configures pin routing and optionally pin electrical features.
 *
 * END ****************************************************************************************************************/
void BOARD_InitPins(void) {
  CLOCK_EnableClock(kCLOCK_Iomuxc);           

  IOMUXC_SetPinMux(IOMUXC_GPIO_AD_B0_00_LPSPI3_SCK, 0U); 
  IOMUXC_SetPinMux(IOMUXC_GPIO_AD_B0_01_LPSPI3_SDO, 0U); 
  IOMUXC_SetPinMux(IOMUXC_GPIO_AD_B0_02_LPSPI3_SDI, 0U); 
  IOMUXC_SetPinMux(IOMUXC_GPIO_AD_B0_05_CSI_DATA08, 0U); 
  IOMUXC_SetPinMux(IOMUXC_GPIO_AD_B0_06_JTAG_TMS, 0U); 
  IOMUXC_SetPinMux(IOMUXC_GPIO_AD_B0_07_JTAG_TCK, 0U); 
  IOMUXC_SetPinMux(IOMUXC_GPIO_AD_B0_08_CSI_DATA05, 0U); 
  IOMUXC_SetPinMux(IOMUXC_GPIO_AD_B0_09_JTAG_TDI, 0U); 
  IOMUXC_SetPinMux(IOMUXC_GPIO_AD_B0_10_JTAG_TDO, 0U); 
  IOMUXC_SetPinMux(IOMUXC_GPIO_AD_B0_11_JTAG_TRSTB, 0U); 
  IOMUXC_SetPinMux(IOMUXC_GPIO_AD_B0_12_LPI2C4_SCL, 0U); 
  IOMUXC_SetPinMux(IOMUXC_GPIO_AD_B0_13_LPI2C4_SDA, 0U); 
  IOMUXC_SetPinMux(IOMUXC_GPIO_AD_B1_00_LPI2C1_SCL, 0U); 
  IOMUXC_SetPinMux(IOMUXC_GPIO_AD_B1_01_LPI2C1_SDA, 0U); 
#if FSL_IOMUXC_DRIVER_VERSION >= MAKE_VERSION(2, 0, 3)
  IOMUXC_SetPinMux(IOMUXC_GPIO_AD_B1_02_LPUART2_TXD, 0U); 
#else
  IOMUXC_SetPinMux(IOMUXC_GPIO_AD_B1_02_LPUART2_TX, 0U); 
#endif
#if FSL_IOMUXC_DRIVER_VERSION >= MAKE_VERSION(2, 0, 3)
  IOMUXC_SetPinMux(IOMUXC_GPIO_AD_B1_03_LPUART2_RXD, 0U); 
#else
  IOMUXC_SetPinMux(IOMUXC_GPIO_AD_B1_03_LPUART2_RX, 0U); 
#endif
  IOMUXC_SetPinMux(IOMUXC_GPIO_AD_B1_04_CSI_PIXCLK, 0U); 
  IOMUXC_SetPinMux(IOMUXC_GPIO_AD_B1_05_CSI_MCLK, 0U); 
  IOMUXC_SetPinMux(IOMUXC_GPIO_AD_B1_06_CSI_VSYNC, 0U); 
  IOMUXC_SetPinMux(IOMUXC_GPIO_AD_B1_07_CSI_HSYNC, 0U); 
  IOMUXC_SetPinMux(IOMUXC_GPIO_AD_B1_08_CSI_DATA09, 0U); 
  IOMUXC_SetPinMux(IOMUXC_GPIO_AD_B1_10_CSI_DATA07, 0U); 
  IOMUXC_SetPinMux(IOMUXC_GPIO_AD_B1_11_CSI_DATA06, 0U); 
  IOMUXC_SetPinMux(IOMUXC_GPIO_AD_B1_13_CSI_DATA04, 0U); 
  IOMUXC_SetPinMux(IOMUXC_GPIO_AD_B1_14_CSI_DATA03, 0U); 
  IOMUXC_SetPinMux(IOMUXC_GPIO_AD_B1_15_CSI_DATA02, 0U); 
  IOMUXC_SetPinMux(IOMUXC_GPIO_B0_04_LPI2C2_SCL, 0U); 
  IOMUXC_SetPinMux(IOMUXC_GPIO_B0_05_LPI2C2_SDA, 0U); 
#if FSL_IOMUXC_DRIVER_VERSION >= MAKE_VERSION(2, 0, 3)
  IOMUXC_SetPinMux(IOMUXC_GPIO_B1_00_FLEXPWM1_PWM3_A, 0U); 
#else
  IOMUXC_SetPinMux(IOMUXC_GPIO_B1_00_FLEXPWM1_PWMA03, 0U); 
#endif
#if FSL_IOMUXC_DRIVER_VERSION >= MAKE_VERSION(2, 0, 3)
  IOMUXC_SetPinMux(IOMUXC_GPIO_B1_01_FLEXPWM1_PWM3_B, 0U); 
#else
  IOMUXC_SetPinMux(IOMUXC_GPIO_B1_01_FLEXPWM1_PWMB03, 0U); 
#endif
#if FSL_IOMUXC_DRIVER_VERSION >= MAKE_VERSION(2, 0, 3)
  IOMUXC_SetPinMux(IOMUXC_GPIO_B1_02_FLEXPWM2_PWM3_A, 0U); 
#else
  IOMUXC_SetPinMux(IOMUXC_GPIO_B1_02_FLEXPWM2_PWMA03, 0U); 
#endif
#if FSL_IOMUXC_DRIVER_VERSION >= MAKE_VERSION(2, 0, 3)
  IOMUXC_SetPinMux(IOMUXC_GPIO_B1_03_FLEXPWM2_PWM3_B, 0U); 
#else
  IOMUXC_SetPinMux(IOMUXC_GPIO_B1_03_FLEXPWM2_PWMB03, 0U); 
#endif
#if FSL_IOMUXC_DRIVER_VERSION >= MAKE_VERSION(2, 0, 3)
  IOMUXC_SetPinMux(IOMUXC_GPIO_EMC_00_SEMC_DA00, 0U); 
#else
  IOMUXC_SetPinMux(IOMUXC_GPIO_EMC_00_SEMC_DATA00, 0U); 
#endif
#if FSL_IOMUXC_DRIVER_VERSION >= MAKE_VERSION(2, 0, 3)
  IOMUXC_SetPinMux(IOMUXC_GPIO_EMC_01_SEMC_DA01, 0U); 
#else
  IOMUXC_SetPinMux(IOMUXC_GPIO_EMC_01_SEMC_DATA01, 0U); 
#endif
#if FSL_IOMUXC_DRIVER_VERSION >= MAKE_VERSION(2, 0, 3)
  IOMUXC_SetPinMux(IOMUXC_GPIO_EMC_02_SEMC_DA02, 0U); 
#else
  IOMUXC_SetPinMux(IOMUXC_GPIO_EMC_02_SEMC_DATA02, 0U); 
#endif
#if FSL_IOMUXC_DRIVER_VERSION >= MAKE_VERSION(2, 0, 3)
  IOMUXC_SetPinMux(IOMUXC_GPIO_EMC_03_SEMC_DA03, 0U); 
#else
  IOMUXC_SetPinMux(IOMUXC_GPIO_EMC_03_SEMC_DATA03, 0U); 
#endif
#if FSL_IOMUXC_DRIVER_VERSION >= MAKE_VERSION(2, 0, 3)
  IOMUXC_SetPinMux(IOMUXC_GPIO_EMC_04_SEMC_DA04, 0U); 
#else
  IOMUXC_SetPinMux(IOMUXC_GPIO_EMC_04_SEMC_DATA04, 0U); 
#endif
#if FSL_IOMUXC_DRIVER_VERSION >= MAKE_VERSION(2, 0, 3)
  IOMUXC_SetPinMux(IOMUXC_GPIO_EMC_05_SEMC_DA05, 0U); 
#else
  IOMUXC_SetPinMux(IOMUXC_GPIO_EMC_05_SEMC_DATA05, 0U); 
#endif
#if FSL_IOMUXC_DRIVER_VERSION >= MAKE_VERSION(2, 0, 3)
  IOMUXC_SetPinMux(IOMUXC_GPIO_EMC_06_SEMC_DA06, 0U); 
#else
  IOMUXC_SetPinMux(IOMUXC_GPIO_EMC_06_SEMC_DATA06, 0U); 
#endif
#if FSL_IOMUXC_DRIVER_VERSION >= MAKE_VERSION(2, 0, 3)
  IOMUXC_SetPinMux(IOMUXC_GPIO_EMC_07_SEMC_DA07, 0U); 
#else
  IOMUXC_SetPinMux(IOMUXC_GPIO_EMC_07_SEMC_DATA07, 0U); 
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
  IOMUXC_SetPinMux(IOMUXC_GPIO_SD_B1_05_FLEXSPI_A_DQS, 0U); 
#else
  IOMUXC_SetPinMux(IOMUXC_GPIO_SD_B1_05_FLEXSPIA_DQS, 0U); 
#endif
#if FSL_IOMUXC_DRIVER_VERSION >= MAKE_VERSION(2, 0, 3)
  IOMUXC_SetPinMux(IOMUXC_GPIO_SD_B1_06_FLEXSPI_A_SS0_B, 0U); 
#else
  IOMUXC_SetPinMux(IOMUXC_GPIO_SD_B1_06_FLEXSPIA_SS0_B, 0U); 
#endif
#if FSL_IOMUXC_DRIVER_VERSION >= MAKE_VERSION(2, 0, 3)
  IOMUXC_SetPinMux(IOMUXC_GPIO_SD_B1_07_FLEXSPI_A_SCLK, 0U); 
#else
  IOMUXC_SetPinMux(IOMUXC_GPIO_SD_B1_07_FLEXSPIA_SCLK, 0U); 
#endif
#if FSL_IOMUXC_DRIVER_VERSION >= MAKE_VERSION(2, 0, 3)
  IOMUXC_SetPinMux(IOMUXC_GPIO_SD_B1_08_FLEXSPI_A_DATA00, 0U); 
#else
  IOMUXC_SetPinMux(IOMUXC_GPIO_SD_B1_08_FLEXSPIA_DATA00, 0U); 
#endif
#if FSL_IOMUXC_DRIVER_VERSION >= MAKE_VERSION(2, 0, 3)
  IOMUXC_SetPinMux(IOMUXC_GPIO_SD_B1_09_FLEXSPI_A_DATA1, 0U); 
#else
  IOMUXC_SetPinMux(IOMUXC_GPIO_SD_B1_09_FLEXSPIA_DATA01, 0U); 
#endif
#if FSL_IOMUXC_DRIVER_VERSION >= MAKE_VERSION(2, 0, 3)
  IOMUXC_SetPinMux(IOMUXC_GPIO_SD_B1_10_FLEXSPI_A_DATA2, 0U); 
#else
  IOMUXC_SetPinMux(IOMUXC_GPIO_SD_B1_10_FLEXSPIA_DATA02, 0U); 
#endif
#if FSL_IOMUXC_DRIVER_VERSION >= MAKE_VERSION(2, 0, 3)
  IOMUXC_SetPinMux(IOMUXC_GPIO_SD_B1_11_FLEXSPI_A_DATA3, 0U); 
#else
  IOMUXC_SetPinMux(IOMUXC_GPIO_SD_B1_11_FLEXSPIA_DATA03, 0U); 
#endif
}
/***********************************************************************************************************************
 * EOF
 **********************************************************************************************************************/
