NU-Horizonsat/ADCS-Camera-Payload-Board/board/clock_config.c

/*
 * How to setup clock using clock driver functions:
 *
 * 1. Call CLOCK_InitXXXPLL() to configure corresponding PLL clock.
 *
 * 2. Call CLOCK_InitXXXpfd() to configure corresponding PLL pfd clock.
 *
 * 3. Call CLOCK_SetMux() to configure corresponding clock source for target clock out.
 *
 * 4. Call CLOCK_SetDiv() to configure corresponding clock divider for target clock out.
 *
 * 5. Call CLOCK_SetXtalFreq() to set XTAL frequency based on board settings.
 *
 */

/* TEXT BELOW IS USED AS SETTING FOR TOOLS *************************************
!!GlobalInfo
product: Clocks v14.0
processor: MIMXRT1052xxxxB
package_id: MIMXRT1052DVL6B
mcu_data: ksdk2_0
processor_version: 16.3.0
 * BE CAREFUL MODIFYING THIS COMMENT - IT IS YAML SETTINGS FOR TOOLS **********/

#include "clock_config.h"
#include "fsl_iomuxc.h"

/*******************************************************************************
 * Definitions
 ******************************************************************************/

/*******************************************************************************
 * Variables
 ******************************************************************************/

/*******************************************************************************
 ************************ BOARD_InitBootClocks function ************************
 ******************************************************************************/
void BOARD_InitBootClocks(void)
{
    BOARD_BootClockRUN();
}

/*******************************************************************************
 ********************** Configuration BOARD_BootClockRUN ***********************
 ******************************************************************************/
/* TEXT BELOW IS USED AS SETTING FOR TOOLS *************************************
!!Configuration
name: BOARD_BootClockRUN
called_from_default_init: true
outputs:
- {id: AHB_CLK_ROOT.outFreq, value: 12 MHz}
- {id: CAN_CLK_ROOT.outFreq, value: 2 MHz}
- {id: CLK_1M.outFreq, value: 1 MHz}
- {id: CLK_24M.outFreq, value: 24 MHz}
- {id: CSI_CLK_ROOT.outFreq, value: 12 MHz}
- {id: ENET_125M_CLK.outFreq, value: 2.4 MHz}
- {id: ENET_25M_REF_CLK.outFreq, value: 1.2 MHz}
- {id: FLEXIO1_CLK_ROOT.outFreq, value: 1.5 MHz}
- {id: FLEXIO2_CLK_ROOT.outFreq, value: 1.5 MHz}
- {id: FLEXSPI_CLK_ROOT.outFreq, value: 2 MHz}
- {id: GPT1_ipg_clk_highfreq.outFreq, value: 3 MHz}
- {id: GPT2_ipg_clk_highfreq.outFreq, value: 3 MHz}
- {id: IPG_CLK_ROOT.outFreq, value: 3 MHz}
- {id: LCDIF_CLK_ROOT.outFreq, value: 3 MHz}
- {id: LPI2C_CLK_ROOT.outFreq, value: 3 MHz}
- {id: LPSPI_CLK_ROOT.outFreq, value: 6 MHz}
- {id: LVDS1_CLK.outFreq, value: 24 MHz}
- {id: MQS_MCLK.outFreq, value: 3 MHz}
- {id: PERCLK_CLK_ROOT.outFreq, value: 3 MHz}
- {id: PLL7_MAIN_CLK.outFreq, value: 24 MHz}
- {id: SAI1_CLK_ROOT.outFreq, value: 3 MHz}
- {id: SAI1_MCLK1.outFreq, value: 3 MHz}
- {id: SAI1_MCLK2.outFreq, value: 3 MHz}
- {id: SAI1_MCLK3.outFreq, value: 1.5 MHz}
- {id: SAI2_CLK_ROOT.outFreq, value: 3 MHz}
- {id: SAI2_MCLK1.outFreq, value: 3 MHz}
- {id: SAI2_MCLK3.outFreq, value: 1.5 MHz}
- {id: SAI3_CLK_ROOT.outFreq, value: 3 MHz}
- {id: SAI3_MCLK1.outFreq, value: 3 MHz}
- {id: SAI3_MCLK3.outFreq, value: 1.5 MHz}
- {id: SEMC_CLK_ROOT.outFreq, value: 4 MHz}
- {id: SPDIF0_CLK_ROOT.outFreq, value: 1.5 MHz}
- {id: TRACE_CLK_ROOT.outFreq, value: 6 MHz}
- {id: UART_CLK_ROOT.outFreq, value: 4 MHz}
- {id: USDHC1_CLK_ROOT.outFreq, value: 12 MHz}
- {id: USDHC2_CLK_ROOT.outFreq, value: 12 MHz}
 * BE CAREFUL MODIFYING THIS COMMENT - IT IS YAML SETTINGS FOR TOOLS **********/

/*******************************************************************************
 * Variables for BOARD_BootClockRUN configuration
 ******************************************************************************/
const clock_arm_pll_config_t armPllConfig_BOARD_BootClockRUN =
    {
        .loopDivider = 98,                        /* PLL loop divider, Fout = Fin * 49 */
        .src = 0,                                 /* Bypass clock source, 0 - OSC 24M, 1 - CLK1_P and CLK1_N */
    };
const clock_sys_pll_config_t sysPllConfig_BOARD_BootClockRUN =
    {
        .loopDivider = 1,                         /* PLL loop divider, Fout = Fin * ( 20 + loopDivider*2 + numerator / denominator ) */
        .numerator = 1,                           /* 30 bit numerator of fractional loop divider */
        .denominator = 60000,                     /* 30 bit denominator of fractional loop divider */
        .src = 0,                                 /* Bypass clock source, 0 - OSC 24M, 1 - CLK1_P and CLK1_N */
    };
const clock_enet_pll_config_t enetPllConfig_BOARD_BootClockRUN =
    {
        .enableClkOutput = true,                  /* Enable the PLL providing the ENET 125MHz reference clock */
        .enableClkOutput25M = true,               /* Enable the PLL providing the ENET 25MHz reference clock */
        .loopDivider = 1,                         /* Set frequency of ethernet reference clock to 2.4 MHz */
        .src = 0,                                 /* Bypass clock source, 0 - OSC 24M, 1 - CLK1_P and CLK1_N */
    };
/*******************************************************************************
 * Code for BOARD_BootClockRUN configuration
 ******************************************************************************/
void BOARD_BootClockRUN(void)
{
    /* Enable 1MHz clock output. */
    XTALOSC24M->OSC_CONFIG2 |= XTALOSC24M_OSC_CONFIG2_ENABLE_1M_MASK;
    /* Use free 1MHz clock output. */
    XTALOSC24M->OSC_CONFIG2 &= ~XTALOSC24M_OSC_CONFIG2_MUX_1M_MASK;
    /* Set XTAL 24MHz clock frequency. */
    CLOCK_SetXtalFreq(24000000U);
    /* Enable XTAL 24MHz clock source. */
    CLOCK_InitExternalClk(0);
    /* Enable internal RC. */
    CLOCK_InitRcOsc24M();
    /* Switch clock source to external OSC. */
    CLOCK_SwitchOsc(kCLOCK_XtalOsc);
    /* Set Oscillator ready counter value. */
    CCM->CCR = (CCM->CCR & (~CCM_CCR_OSCNT_MASK)) | CCM_CCR_OSCNT(127);
    /* Setting PeriphClk2Mux and PeriphMux to provide stable clock before PLLs are initialed */
    CLOCK_SetMux(kCLOCK_PeriphClk2Mux, 1); /* Set PERIPH_CLK2 MUX to OSC */
    CLOCK_SetMux(kCLOCK_PeriphMux, 1);     /* Set PERIPH_CLK MUX to PERIPH_CLK2 */
    /* Set AHB_PODF. */
    CLOCK_SetDiv(kCLOCK_AhbDiv, 0);
    /* Disable IPG clock gate. */
    CLOCK_DisableClock(kCLOCK_Adc1);
    CLOCK_DisableClock(kCLOCK_Adc2);
    CLOCK_DisableClock(kCLOCK_Xbar1);
    CLOCK_DisableClock(kCLOCK_Xbar2);
    CLOCK_DisableClock(kCLOCK_Xbar3);
    /* Set IPG_PODF. */
    CLOCK_SetDiv(kCLOCK_IpgDiv, 3);
    /* Set ARM_PODF. */
    CLOCK_SetDiv(kCLOCK_ArmDiv, 1);
    /* Set PERIPH_CLK2_PODF. */
    CLOCK_SetDiv(kCLOCK_PeriphClk2Div, 0);
    /* Disable PERCLK clock gate. */
    CLOCK_DisableClock(kCLOCK_Gpt1);
    CLOCK_DisableClock(kCLOCK_Gpt1S);
    CLOCK_DisableClock(kCLOCK_Gpt2);
    CLOCK_DisableClock(kCLOCK_Gpt2S);
    CLOCK_DisableClock(kCLOCK_Pit);
    /* Set PERCLK_PODF. */
    CLOCK_SetDiv(kCLOCK_PerclkDiv, 0);
    /* Disable USDHC1 clock gate. */
    CLOCK_DisableClock(kCLOCK_Usdhc1);
    /* Set USDHC1_PODF. */
    CLOCK_SetDiv(kCLOCK_Usdhc1Div, 1);
    /* Set Usdhc1 clock source. */
    CLOCK_SetMux(kCLOCK_Usdhc1Mux, 0);
    /* Disable USDHC2 clock gate. */
    CLOCK_DisableClock(kCLOCK_Usdhc2);
    /* Set USDHC2_PODF. */
    CLOCK_SetDiv(kCLOCK_Usdhc2Div, 1);
    /* Set Usdhc2 clock source. */
    CLOCK_SetMux(kCLOCK_Usdhc2Mux, 0);
    /* In SDK projects, SDRAM (configured by SEMC) will be initialized in either debug script or dcd.
     * With this macro SKIP_SYSCLK_INIT, system pll (selected to be SEMC source clock in SDK projects) will be left unchanged.
     * Note: If another clock source is selected for SEMC, user may want to avoid changing that clock as well.*/
#ifndef SKIP_SYSCLK_INIT
    /* Disable Semc clock gate. */
    CLOCK_DisableClock(kCLOCK_Semc);
    /* Set SEMC_PODF. */
    CLOCK_SetDiv(kCLOCK_SemcDiv, 2);
    /* Set Semc alt clock source. */
    CLOCK_SetMux(kCLOCK_SemcAltMux, 0);
    /* Set Semc clock source. */
    CLOCK_SetMux(kCLOCK_SemcMux, 0);
#endif
    /* In SDK projects, external flash (configured by FLEXSPI) will be initialized by dcd.
     * With this macro XIP_EXTERNAL_FLASH, usb1 pll (selected to be FLEXSPI clock source in SDK projects) will be left unchanged.
     * Note: If another clock source is selected for FLEXSPI, user may want to avoid changing that clock as well.*/
#if !(defined(XIP_EXTERNAL_FLASH) && (XIP_EXTERNAL_FLASH == 1))
    /* Disable Flexspi clock gate. */
    CLOCK_DisableClock(kCLOCK_FlexSpi);
    /* Set FLEXSPI_PODF. */
    CLOCK_SetDiv(kCLOCK_FlexspiDiv, 1);
    /* Set Flexspi clock source. */
    CLOCK_SetMux(kCLOCK_FlexspiMux, 0);
#endif
    /* Disable CSI clock gate. */
    CLOCK_DisableClock(kCLOCK_Csi);
    /* Set CSI_PODF. */
    CLOCK_SetDiv(kCLOCK_CsiDiv, 1);
    /* Set Csi clock source. */
    CLOCK_SetMux(kCLOCK_CsiMux, 0);
    /* Disable LPSPI clock gate. */
    CLOCK_DisableClock(kCLOCK_Lpspi1);
    CLOCK_DisableClock(kCLOCK_Lpspi2);
    CLOCK_DisableClock(kCLOCK_Lpspi3);
    CLOCK_DisableClock(kCLOCK_Lpspi4);
    /* Set LPSPI_PODF. */
    CLOCK_SetDiv(kCLOCK_LpspiDiv, 3);
    /* Set Lpspi clock source. */
    CLOCK_SetMux(kCLOCK_LpspiMux, 2);
    /* Disable TRACE clock gate. */
    CLOCK_DisableClock(kCLOCK_Trace);
    /* Set TRACE_PODF. */
    CLOCK_SetDiv(kCLOCK_TraceDiv, 3);
    /* Set Trace clock source. */
    CLOCK_SetMux(kCLOCK_TraceMux, 2);
    /* Disable SAI1 clock gate. */
    CLOCK_DisableClock(kCLOCK_Sai1);
    /* Set SAI1_CLK_PRED. */
    CLOCK_SetDiv(kCLOCK_Sai1PreDiv, 3);
    /* Set SAI1_CLK_PODF. */
    CLOCK_SetDiv(kCLOCK_Sai1Div, 1);
    /* Set Sai1 clock source. */
    CLOCK_SetMux(kCLOCK_Sai1Mux, 0);
    /* Disable SAI2 clock gate. */
    CLOCK_DisableClock(kCLOCK_Sai2);
    /* Set SAI2_CLK_PRED. */
    CLOCK_SetDiv(kCLOCK_Sai2PreDiv, 3);
    /* Set SAI2_CLK_PODF. */
    CLOCK_SetDiv(kCLOCK_Sai2Div, 1);
    /* Set Sai2 clock source. */
    CLOCK_SetMux(kCLOCK_Sai2Mux, 0);
    /* Disable SAI3 clock gate. */
    CLOCK_DisableClock(kCLOCK_Sai3);
    /* Set SAI3_CLK_PRED. */
    CLOCK_SetDiv(kCLOCK_Sai3PreDiv, 3);
    /* Set SAI3_CLK_PODF. */
    CLOCK_SetDiv(kCLOCK_Sai3Div, 1);
    /* Set Sai3 clock source. */
    CLOCK_SetMux(kCLOCK_Sai3Mux, 0);
    /* Disable Lpi2c clock gate. */
    CLOCK_DisableClock(kCLOCK_Lpi2c1);
    CLOCK_DisableClock(kCLOCK_Lpi2c2);
    CLOCK_DisableClock(kCLOCK_Lpi2c3);
    /* Set LPI2C_CLK_PODF. */
    CLOCK_SetDiv(kCLOCK_Lpi2cDiv, 0);
    /* Set Lpi2c clock source. */
    CLOCK_SetMux(kCLOCK_Lpi2cMux, 0);
    /* Disable CAN clock gate. */
    CLOCK_DisableClock(kCLOCK_Can1);
    CLOCK_DisableClock(kCLOCK_Can2);
    CLOCK_DisableClock(kCLOCK_Can1S);
    CLOCK_DisableClock(kCLOCK_Can2S);
    /* Set CAN_CLK_PODF. */
    CLOCK_SetDiv(kCLOCK_CanDiv, 1);
    /* Set Can clock source. */
    CLOCK_SetMux(kCLOCK_CanMux, 2);
    /* Disable UART clock gate. */
    CLOCK_DisableClock(kCLOCK_Lpuart1);
    CLOCK_DisableClock(kCLOCK_Lpuart2);
    CLOCK_DisableClock(kCLOCK_Lpuart3);
    CLOCK_DisableClock(kCLOCK_Lpuart4);
    CLOCK_DisableClock(kCLOCK_Lpuart5);
    CLOCK_DisableClock(kCLOCK_Lpuart6);
    CLOCK_DisableClock(kCLOCK_Lpuart7);
    CLOCK_DisableClock(kCLOCK_Lpuart8);
    /* Set UART_CLK_PODF. */
    CLOCK_SetDiv(kCLOCK_UartDiv, 0);
    /* Set Uart clock source. */
    CLOCK_SetMux(kCLOCK_UartMux, 0);
    /* Disable LCDIF clock gate. */
    CLOCK_DisableClock(kCLOCK_LcdPixel);
    /* Set LCDIF_PRED. */
    CLOCK_SetDiv(kCLOCK_LcdifPreDiv, 1);
    /* Set LCDIF_CLK_PODF. */
    CLOCK_SetDiv(kCLOCK_LcdifDiv, 3);
    /* Set Lcdif pre clock source. */
    CLOCK_SetMux(kCLOCK_LcdifPreMux, 5);
    /* Disable SPDIF clock gate. */
    CLOCK_DisableClock(kCLOCK_Spdif);
    /* Set SPDIF0_CLK_PRED. */
    CLOCK_SetDiv(kCLOCK_Spdif0PreDiv, 1);
    /* Set SPDIF0_CLK_PODF. */
    CLOCK_SetDiv(kCLOCK_Spdif0Div, 7);
    /* Set Spdif clock source. */
    CLOCK_SetMux(kCLOCK_SpdifMux, 3);
    /* Disable Flexio1 clock gate. */
    CLOCK_DisableClock(kCLOCK_Flexio1);
    /* Set FLEXIO1_CLK_PRED. */
    CLOCK_SetDiv(kCLOCK_Flexio1PreDiv, 1);
    /* Set FLEXIO1_CLK_PODF. */
    CLOCK_SetDiv(kCLOCK_Flexio1Div, 7);
    /* Set Flexio1 clock source. */
    CLOCK_SetMux(kCLOCK_Flexio1Mux, 3);
    /* Disable Flexio2 clock gate. */
    CLOCK_DisableClock(kCLOCK_Flexio2);
    /* Set FLEXIO2_CLK_PRED. */
    CLOCK_SetDiv(kCLOCK_Flexio2PreDiv, 1);
    /* Set FLEXIO2_CLK_PODF. */
    CLOCK_SetDiv(kCLOCK_Flexio2Div, 7);
    /* Set Flexio2 clock source. */
    CLOCK_SetMux(kCLOCK_Flexio2Mux, 3);
    /* Set Pll3 sw clock source. */
    CLOCK_SetMux(kCLOCK_Pll3SwMux, 0);
    /* Init ARM PLL. */
    CLOCK_InitArmPll(&armPllConfig_BOARD_BootClockRUN);
    /* Bypass for ARM PLL. */
    CLOCK_SetPllBypass(CCM_ANALOG, kCLOCK_PllArm, 1);
    /* In SDK projects, SDRAM (configured by SEMC) will be initialized in either debug script or dcd.
     * With this macro SKIP_SYSCLK_INIT, system pll (selected to be SEMC source clock in SDK projects) will be left unchanged.
     * Note: If another clock source is selected for SEMC, user may want to avoid changing that clock as well.*/
#ifndef SKIP_SYSCLK_INIT
#if defined(XIP_BOOT_HEADER_DCD_ENABLE) && (XIP_BOOT_HEADER_DCD_ENABLE == 1)
    #warning "SKIP_SYSCLK_INIT should be defined to keep system pll (selected to be SEMC source clock in SDK projects) unchanged."
#endif
    /* Init System PLL. */
    CLOCK_InitSysPll(&sysPllConfig_BOARD_BootClockRUN);
    /* Init System pfd0. */
    CLOCK_InitSysPfd(kCLOCK_Pfd0, 27);
    /* Init System pfd1. */
    CLOCK_InitSysPfd(kCLOCK_Pfd1, 16);
    /* Init System pfd2. */
    CLOCK_InitSysPfd(kCLOCK_Pfd2, 24);
    /* Init System pfd3. */
    CLOCK_InitSysPfd(kCLOCK_Pfd3, 16);
    /* Bypass System PLL. */
    CLOCK_SetPllBypass(CCM_ANALOG, kCLOCK_PllSys, 1);
#endif
    /* In SDK projects, external flash (configured by FLEXSPI) will be initialized by dcd.
     * With this macro XIP_EXTERNAL_FLASH, usb1 pll (selected to be FLEXSPI clock source in SDK projects) will be left unchanged.
     * Note: If another clock source is selected for FLEXSPI, user may want to avoid changing that clock as well.*/
#if !(defined(XIP_EXTERNAL_FLASH) && (XIP_EXTERNAL_FLASH == 1))
    /* DeInit Usb1 PLL. */
    CLOCK_DeinitUsb1Pll();
    /* Bypass Usb1 PLL. */
    CLOCK_SetPllBypass(CCM_ANALOG, kCLOCK_PllUsb1, 1);
    /* Enable Usb1 PLL output. */
    CCM_ANALOG->PLL_USB1 |= CCM_ANALOG_PLL_USB1_ENABLE_MASK;
#endif
    /* DeInit Audio PLL. */
    CLOCK_DeinitAudioPll();
    /* Bypass Audio PLL. */
    CLOCK_SetPllBypass(CCM_ANALOG, kCLOCK_PllAudio, 1);
    /* Set divider for Audio PLL. */
    CCM_ANALOG->MISC2 &= ~CCM_ANALOG_MISC2_AUDIO_DIV_LSB_MASK;
    CCM_ANALOG->MISC2 &= ~CCM_ANALOG_MISC2_AUDIO_DIV_MSB_MASK;
    /* Enable Audio PLL output. */
    CCM_ANALOG->PLL_AUDIO |= CCM_ANALOG_PLL_AUDIO_ENABLE_MASK;
    /* DeInit Video PLL. */
    CLOCK_DeinitVideoPll();
    /* Bypass Video PLL. */
    CCM_ANALOG->PLL_VIDEO |= CCM_ANALOG_PLL_VIDEO_BYPASS_MASK;
    /* Set divider for Video PLL. */
    CCM_ANALOG->MISC2 = (CCM_ANALOG->MISC2 & (~CCM_ANALOG_MISC2_VIDEO_DIV_MASK)) | CCM_ANALOG_MISC2_VIDEO_DIV(0);
    /* Enable Video PLL output. */
    CCM_ANALOG->PLL_VIDEO |= CCM_ANALOG_PLL_VIDEO_ENABLE_MASK;
    /* Init Enet PLL. */
    CLOCK_InitEnetPll(&enetPllConfig_BOARD_BootClockRUN);
    /* Bypass Enet PLL. */
    CLOCK_SetPllBypass(CCM_ANALOG, kCLOCK_PllEnet, 1);
    /* DeInit Usb2 PLL. */
    CLOCK_DeinitUsb2Pll();
    /* Bypass Usb2 PLL. */
    CLOCK_SetPllBypass(CCM_ANALOG, kCLOCK_PllUsb2, 1);
    /* Enable Usb2 PLL output. */
    CCM_ANALOG->PLL_USB2 |= CCM_ANALOG_PLL_USB2_ENABLE_MASK;
    /* Set preperiph clock source. */
    CLOCK_SetMux(kCLOCK_PrePeriphMux, 3);
    /* Set periph clock source. */
    CLOCK_SetMux(kCLOCK_PeriphMux, 0);
    /* Set periph clock2 clock source. */
    CLOCK_SetMux(kCLOCK_PeriphClk2Mux, 0);
    /* Set per clock source. */
    CLOCK_SetMux(kCLOCK_PerclkMux, 0);
    /* Set lvds1 clock source. */
    CCM_ANALOG->MISC1 = (CCM_ANALOG->MISC1 & (~CCM_ANALOG_MISC1_LVDS1_CLK_SEL_MASK)) | CCM_ANALOG_MISC1_LVDS1_CLK_SEL(0);
    /* Set clock out1 divider. */
    CCM->CCOSR = (CCM->CCOSR & (~CCM_CCOSR_CLKO1_DIV_MASK)) | CCM_CCOSR_CLKO1_DIV(0);
    /* Set clock out1 source. */
    CCM->CCOSR = (CCM->CCOSR & (~CCM_CCOSR_CLKO1_SEL_MASK)) | CCM_CCOSR_CLKO1_SEL(1);
    /* Set clock out2 divider. */
    CCM->CCOSR = (CCM->CCOSR & (~CCM_CCOSR_CLKO2_DIV_MASK)) | CCM_CCOSR_CLKO2_DIV(0);
    /* Set clock out2 source. */
    CCM->CCOSR = (CCM->CCOSR & (~CCM_CCOSR_CLKO2_SEL_MASK)) | CCM_CCOSR_CLKO2_SEL(18);
    /* Set clock out1 drives clock out1. */
    CCM->CCOSR &= ~CCM_CCOSR_CLK_OUT_SEL_MASK;
    /* Disable clock out1. */
    CCM->CCOSR &= ~CCM_CCOSR_CLKO1_EN_MASK;
    /* Disable clock out2. */
    CCM->CCOSR &= ~CCM_CCOSR_CLKO2_EN_MASK;
    /* Set SAI1 MCLK1 clock source. */
    IOMUXC_SetSaiMClkClockSource(IOMUXC_GPR, kIOMUXC_GPR_SAI1MClk1Sel, 0);
    /* Set SAI1 MCLK2 clock source. */
    IOMUXC_SetSaiMClkClockSource(IOMUXC_GPR, kIOMUXC_GPR_SAI1MClk2Sel, 0);
    /* Set SAI1 MCLK3 clock source. */
    IOMUXC_SetSaiMClkClockSource(IOMUXC_GPR, kIOMUXC_GPR_SAI1MClk3Sel, 0);
    /* Set SAI2 MCLK3 clock source. */
    IOMUXC_SetSaiMClkClockSource(IOMUXC_GPR, kIOMUXC_GPR_SAI2MClk3Sel, 0);
    /* Set SAI3 MCLK3 clock source. */
    IOMUXC_SetSaiMClkClockSource(IOMUXC_GPR, kIOMUXC_GPR_SAI3MClk3Sel, 0);
    /* Set MQS configuration. */
    IOMUXC_MQSConfig(IOMUXC_GPR,kIOMUXC_MqsPwmOverSampleRate32, 0);
    /* Set ENET Ref clock source. */
#if defined(IOMUXC_GPR_GPR1_ENET_REF_CLK_DIR_MASK)
    IOMUXC_GPR->GPR1 &= ~IOMUXC_GPR_GPR1_ENET_REF_CLK_DIR_MASK;
#elif defined(IOMUXC_GPR_GPR1_ENET1_TX_CLK_DIR_MASK)
    /* Backward compatibility for original bitfield name */
    IOMUXC_GPR->GPR1 &= ~IOMUXC_GPR_GPR1_ENET1_TX_CLK_DIR_MASK;
#else
#error "Neither IOMUXC_GPR_GPR1_ENET_REF_CLK_DIR_MASK nor IOMUXC_GPR_GPR1_ENET1_TX_CLK_DIR_MASK is defined."
#endif /* defined(IOMUXC_GPR_GPR1_ENET_REF_CLK_DIR_MASK) */
    /* Set GPT1 High frequency reference clock source. */
    IOMUXC_GPR->GPR5 &= ~IOMUXC_GPR_GPR5_VREF_1M_CLK_GPT1_MASK;
    /* Set GPT2 High frequency reference clock source. */
    IOMUXC_GPR->GPR5 &= ~IOMUXC_GPR_GPR5_VREF_1M_CLK_GPT2_MASK;
    /* Set SystemCoreClock variable. */
    SystemCoreClock = BOARD_BOOTCLOCKRUN_CORE_CLOCK;
}
