NU-Horizonsat/ADCS-Camera-Payload-Board/(commit log)

2025-03-23 started layout
    [RT1050.kicad_pcb, bootconfig.kicad_sch, connectors.kicad_sch, csi.kicad_sch, mag_drivers.kicad_sch, mcu.kicad_sch, mcu_power.kicad_sch, usb_debug.kicad_sch]
2025-03-24 redid power rails to allow for sleep
    [mcu_power.kicad_sch]
2025-03-30 finished layout of v0.2!
    [RT1050.kicad_pcb, connectors.kicad_sch, csi.kicad_sch, mag_drivers.kicad_sch, mcu_power.kicad_sch, usb_debug.kicad_sch, watchdog.kicad_sch]
2025-04-02 added testpoints
    [RT1050.kicad_pcb, RT1050.step, mag_drivers.kicad_sch, mcu_power.kicad_sch, sensors.kicad_sch]
