NU-Horizonsat/ADCS-Camera-Payload-Board/(notices)

Notices in the files:
parts and their libraries:
License: Apache-2.0
